NewbieXvwu/maze-car/cad/ASSETS.md

# 素材来源

本模型的几何**全部由参数生成**（dsh-cad / OCCT），没有引入任何外部模型文件。

| 项 | 来源 | 许可 |
|---|---|---|
| 整车几何 | 本项目参数化建模（`cad/params.json`） | 本项目 |
| 底板孔位 | `firmware/board/eda/board_setup.py` 的 M3_POS | 本项目 |
| 轮/电机/万向轮外形 | 按标称尺寸简化（N20、Ø42 轮、Ø12 珠万向轮 ×2 前后） | 自建 |
| 电池盒 | 按采购的 2×18650 串联盒 77×40×20 简化 | 自建 |
| 渲染/总装图 | `cad/render.py`、`cad/drawing.py` 读 `out/parts/` 逐件 STL | 本项目 |

## 若以后引入 CC0 素材

只用于**外观细节**（如轮胎花纹、螺丝头），不参与尺寸链；下载后记录：

| 文件 | 来源 URL | 许可 | 用在哪 |
|---|---|---|---|
| — | — | — | — |

原则：
- 尺寸链上的零件必须参数化，不拿扫描/下载模型顶替。
- CC0 素材只做视觉，不改 `params.json` 的数值。
- 记录来源与许可，方便后面换掉。
