NewbieXvwu/maze-car/cad/CHECKLIST.md

# 实测数据回来后的核对清单

> 用法：把实测值填进 `cad/params.json` 的 `measured` 字段（单位 mm），然后
> `python3 cad/check.py`，全 PASS 再让我重建模型。

## A. 填数前

- [ ] 卡尺/钢尺量完 `cad/MEASURE.md` 的六项关键尺寸
- [ ] 拍好照片（电机+支架侧面/底面、电池盒、主板背面、三个模块、万向轮）
- [ ] 确认轮子实际直径（标称 42，实测可能是 41–43）
- [ ] 确认电机是 N20 还是 N30（外形差 2–3 mm）

## B. 填数

- [ ] `axle.wheel_d`、`axle.wheel_w`、`axle.track`
- [ ] `motor.body_w/body_h/body_len/encoder_len/shaft_len`
- [ ] `motor` 支架孔距（模型里没有这一项，需要新增 `bracket_hole_dx/dy`）
- [ ] `battery.box_len/box_wid/box_h/x0/y0/z0`（装在两电机顶上，宽度不能超过 y ±20）
- [ ] `caster.height/base_d/ball_d`（圆形、方形两只分别量；`x_front`/`x_rear`）
- [ ] `chassis.plate_thk`、`ground_clearance`、`standoff_h`（M3×32；用 M3×30+垫片时改 30）
- [ ] `tof.module_l/module_w/module_t/hole_dx`
- [ ] `pcb` 实测厚度与 M3 孔位
- [ ] 质量：`masses.*`（有厨房秤最好，没有就按目录估）

## C. 自检

- [ ] `python3 cad/check.py` 全 PASS（重点看重心与轮子是否蹭板）
- [ ] 轮内侧面与底板边至少留 1 mm
- [ ] 主板底面比轮顶高 6 mm 以上（当前 48 vs 42）
- [ ] 电池顶离主板底至少 1 mm（当前 46 vs 48，2 mm）
- [ ] 电池盒不碰四根铜柱（内边 y 35.6、x 36.48）
- [ ] 两只万向轮的球底与两驱动轮同时着地（四轮共面）
- [ ] 镜头离地 50–100 mm，且比轮顶高 10 mm 以上
- [ ] 重心横向 |y| < 40（左右对称装配自然满足）

## D. 重建后目视检查

- [ ] 四视图里没有零件互相穿插（看 `out/render-views.png`）
- [ ] 三颗测距的镜头都没被龙门/立柱挡住
- [ ] 电机线、编码器线不被轮子扫到
- [ ] 前后万向轮球底与两轮同时着地（同一 z=0 平面）
- [ ] 整车最高点（69）不超赛道限高（如有）

## E. 电气（装车前）

- [ ] 3V3 对 GND 不短路（万用表蜂鸣档）
- [ ] VBAT 对 GND 不短路
- [ ] 三个 1×6 座的第 1 脚都是 3V3、第 2 脚都是 GND（插错会烧模块）
- [ ] I2C 扫描能看到 0x30/0x31/0x32（三颗测距）与 0x68（MPU）
- [ ] 上电顺序：先电池、后 USB（或按固件说明）

## F. 装车后

- [ ] 手动推车，四轮都着地、车头车尾都不跷，三颗测距读数随距离线性变化
- [ ] 30 cm 通道正中，左右读数都 ≈102 mm
- [ ] 手在正前方 5 cm 挡住，前测距 ≈50 mm
- [ ] 原地转向时轮子不蹭底板、线不被拉断
- [ ] 连续跑 10 分钟，Mini560 与三颗测距不烫手
