NewbieXvwu/maze-car/docs/赛情与决策.md

# 迷宫小车：赛情与决策（更新于 11/10）

## 当前进度（11/10）
- 物料全部到手；车还没组装，还没去过试车场地。开发板烧录交给了本地的 Agent。
- 开发板确认是 VCC-GND 的 YD-ESP32-S3（N8R2），排针和 DevKitC-1 相同。
- 固件已写好（`firmware/`）：逐个模块体检的串口命令、主程序、WiFi 遥测和回放。只做了电脑上的语法检查，还没在真板子上编译过。
- 洞洞板布线已排好（`firmware/board/`，交互布线图已发布成 artifact）：约 9 × 8.7 cm，52 根线分 7 步焊。为了让线横平竖直，11/10 重新分配了 GPIO，config.h 已同步。
- 组装成了关键路径：软件已经等着硬件了。

## 赛事
- 第九届长安大学迷宫智能小车大赛，电控科协承办。我们：两名大一，迷宫组（幻灯片里也叫"避障组"，两个名字混用，应该只是改名）。
- 宣讲会 11/7（周六）晚。
- **比赛 11/15（周日），暂定**；具体时间在比赛交流群（QQ）里通知，主办方也会发短信或 QQ。
- 地点：**机器人学院楼二楼，创客基地旁**。
- 试车：预计 11/9 起开放比赛场地，在开放时间内去。
- 当天流程（宣讲会原文要点）：每队至少到场一人，带车先签到；场内同时只放循迹、避障各两队，其余在实验室外等；**比赛期间不得用手辅助小车**；共三次机会，三次跑完后可以查看成绩，有异议当场提出。
- 往届参考（官网新闻）：2022 年每队约 15 分钟比赛时间、三次机会；2023 年按最终用时排名，并看是否自制，分初级组和高级组；2025 年"以赛道完成度为基础，结合完成时间"。
- 自制条款（今年原话）："自己**完全**设计电路、组装、焊接和设计程序的小车视为自制小车……自制小车不是必要的，自制难，但优势也大。"

## 赛道（宣讲会公布，已确认现场就是这张图）
- **180 × 180 cm，通道宽 30 cm**，横平竖直，正好是 6 × 6 的 30 cm 网格。已画成 `maze-sim/track_2026.txt`。
- **只有一条路**：36 格每格经过一次，没有岔路、没有死胡同、没有环。入口在左上角朝下进，出口紧挨着入口，也在上边。
- 路线：左列直下 → 底边向右 → 绕回来向左 → 中间蛇形上下四趟 → 顶边向左 → 出口。全长约 10.8 m，**14 个弯**，顺序是 `L L L R R R L L R R L L L R`（8 左 6 右）。中间蛇形是 4 个"隔一格连转两次"的 U 形弯。
- 每个弯都是"前方堵死、只有一侧能走"的拐角。
- 推论：左手、右手跑出来是同一条路线；"看图选手""记忆回放"在这条赛道上没有意义。比的就是**又快又不碰墙**。

## 已定方案
- 硬件：ESP32-S3 N8R2；N20 编码器电机 6V 300 转（1:50），配 42mm 轮子，两轮差速；四轮布局 = 左右驱动轮 + 车头/车尾各 1 只万向轮；TB6612；VL53L0X ×3（左/前/右）；MPU6050；2 节 18650 串联（电池盒骑在两电机顶上，整备约 409 g，重心 x≈+4）；固定 5V 降压。模块插在排母上，排母焊在洞洞板上；电池用防反插接头。接线表见 `firmware/README.md`，参数和坑见《硬件笔记》。
- 自制路线：用模块 + 自己画原理图 + 自己焊洞洞板 + 自己写全部程序。任何可能威胁完赛的"更纯正的自制"一律不做：没完赛的自制车，照样排在所有完赛车后面。
- 不上专业物理仿真。最大的不确定因素（VL53L0X 在纸板上的真实读数、地面摩擦、电机参数）只能实测，用真车数据校准现有的二维仿真。
- 主办方已确认：**WiFi 无线调试可以用，比赛时必须关掉**。比赛当天烧 `TELEMETRY 0` 的版本。
- 软件：沿墙走 + 左手法则，加"已知赛道模式"：不找侧面岔路，只在前墙处转弯；起步前方通就直行；转完第 14 个弯再走 35 cm 自动停车（不然出了出口会左转两次、从入口钻回去）。**不做记忆回放，不做洪水填充，不做圆弧转弯**（见下）。
- 拨码 1：稳妥档（巡航 0.38 m/s）/ 快档（只提巡航速度，默认 0.55 m/s）。拨码 2：比赛赛道模式 / 通用迷宫模式（万一布局变了的兜底）。
- 开发优先级：沿墙走稳 → 陀螺仪转弯转准 → 整条赛道稳妥档连续 10 次完赛 → 快档。
- 比赛打法：第一次稳妥档，先保住一个完赛成绩；第二、三次快档冲时间。

## 时间花在哪、怎么变快（仿真结果）
- 比赛赛道模式（和固件一致）：100 次随机扰动（墙缝、墙歪、电机差异、噪声）全部完赛，中位约 41 秒；很滑的地面 + 3 倍陀螺仪零漂也全部完赛，中位约 41.5 秒。
- 车摆在入口线外 12 cm 发车：比赛赛道模式 40/40 完赛；通用模式 32/40 失败（两侧看着空，起步就转弯了）。所以比赛时拨码 2 一定在 OFF。
- 巡航速度 0.5 m/s 约 35 秒，0.65 m/s 约 31 秒（仿真里都 100% 完赛，但仿真对真实地面偏乐观，以实车为准）。
- 11/10 快档扫描（各 40 次，比赛赛道模式）：正常地面 0.55 / 0.65 / 0.70 m/s 分别约 33.1 / 30.9 / 30.1 秒；很滑的地面加 3 倍零漂约 33.8 / 31.5 / 30.7 秒，全部完赛。0.65 以上几乎不再变快（时间都在弯里）。真车的上限是电机：带负载估计只有约 0.7 m/s，巡航超过实测 `vmax_mm_s` 的 85% 左右，就没有余量留给差速纠偏了。快档默认 0.55，实测 vmax 之后最多试到 0.6–0.65。
- **一圈里约 9 秒纯粹花在原地转弯上**。圆弧转弯是最大的提速点，但要在真车上调，时间不够，砍掉。除非 11/13 中午前稳妥档已经连续 10 次完赛，再考虑。
- 30 cm 通道里车（宽 11 cm）每边余量约 9.5 cm；车身对角半长约 8.1 cm，原地转弯不会扫墙。
- 11/10 参数调整：侧面开口阈值 `open_th_mm` 300 → 250（格距变成 300 后，300 正好卡在边上，随机迷宫里会把路口判晚）；刹车减速度 1500 → 1000 mm/s²（滑地上会冲过停车点、转弯时扫到前墙；改完不影响用时）。

## 仿真器（项目里 maze-sim/ 文件夹）
- brain.cpp 是小车的大脑，仿真和上车用的是同一份代码；sim.py 模拟电机、打滑、25° 光锥的激光测距、陀螺仪零漂、纸板墙的缝和歪斜。默认格距 300 mm。
- 跑比赛赛道：`python sim.py --maze track_2026.txt --race`。
- 真车数据回放：`python replay_log.py runs/xxx.csv --png out.png`。已经用"模拟车 → UDP → telemetry.py → csv → 回放"整条链路测过，回放和原始决策完全一致。
- 随机迷宫仍然保留，用来兜底：如果比赛当天布局和图不一样，通用模式照样能走（30 cm 格距的随机 6×6 迷宫，左右手各 60 次全部完赛）。之前写的"60 次全部完赛"其实是在 380 mm 格距下跑的（批量模式忽略了 `--cell`，已修）。
- 仿真已经找出并修掉的问题：
  1. 25° 光锥会扫到路口处横着的墙，开口看起来"开得晚"。路口中心改为吸附到网格位置。
  2. 读数介于"有墙"和"开口"之间的过渡区时，车会朝着并不存在的"远墙"靠过去。过渡区读数不再用于居中，路口中心改用更低的判定阈值。
  3. 跑一分钟以上后，陀螺仪零漂累积到 8° 以上，车斜着贴墙。改为沿墙行驶时用侧面读数随里程的变化来校正航向。
  4. 一次误读就可能让手"贴"到孤岛上无限绕圈。用航位推算记录"在哪一格、朝哪"，同一状态出现第二次就换手。
  5. 出了出口会从入口钻回去：数弯停车。
- 硬件安装要求：左右测距装在车轮轴正上方；前测距在车轮轴前方约 55 mm；车身以车轮轴为中心。装法不同就改 BrainParams。
- `claude/maze_sim.py`（左手/右手/回放/洪水填充的策略对比）是赛道公布之前写的，已经没有参考价值。

## 日程（11/10 按实际进度重排）
| 日期 | 安排 |
|---|---|
| 11/10 周二 | 开发板烧录跑通（`?` 有回应就行）；对照接线表在洞洞板上排好位置 |
| 11/11 周三 | 焊接，装一个测一个：先陀螺仪和三颗测距（`i` `g` `d`），再电机驱动和编码器（`e` `m`），最后电源和分压（`b`）。改好 config.h 里的正负号 |
| 11/12 周四 | 第一次落地：直线居中、原地转弯；用纸箱搭中间蛇形那段（约 150 × 90 cm）。场地开放就去试车（见下方清单） |
| 11/13 周五 | 整条赛道稳妥档连续 10 次完赛；再试快档 |
| 11/14 周六 | 参数 `save`；改 `TELEMETRY 0` 烧比赛版；电池充满；照接线表在嘉立创EDA画原理图；两人互相模拟问辩 |
| 11/15 周日 | 比赛（具体时间看群通知） |

分工：一人主攻硬件（焊接、接线、结构），一人主攻软件；但两个人都要能讲清整辆车。

## 待问主办方
计分规则是否沿用往届 / 计时从哪到哪，车出了出口能不能拿车 / 碰墙是否扣分、卡住怎么算 / 三次之间能否改程序、换电池 / 用模块加洞洞板算不算"完全设计电路" / 地面是什么材质。

## 第一次去试车场地的清单（场地时间紧，按顺序做）
1. 拍照和测量（约 5 分钟）：站高拍完整俯视照；多量几处通道宽度和墙厚，填进 cell_mm、wall_half_mm；看清地面材质、墙高、墙顶和接缝有没有锡箔胶带。车没装好也一定要去做这一步。
2. 静态标定（约 5 分钟）：车摆在格子正中，`d` 看三个测距，和理论值对照（侧面约 102 mm，前方停车点约 92 mm）；再把车摆在开口旁边，看开口处的读数。
3. 打滑测试（约 2 分钟）：猛起步、急停，比较编码器里程和实际走的距离。
4. 剩下的时间：整条赛道完整跑几次，全程录像；开着 telemetry.py 录数据，回去用 replay_log.py 复现。
