NewbieXvwu/maze-car/docs/采购进度.md

# 物料清单（11/10：已全部购入）

按 11/5 定下的清单原样买齐，没有换用省钱的替代款。价格留着，技术问辩被问到成本时用得上。

| 来源 | 商品 | 规格 | 数量 | 单价（元） |
|---|---|---|---|---|
| 淘宝·必晖数码 | 12GA-N20 霍尔编码器电机套装（含 42mm 轮子、支架） | 6V 300 转/分 | 3（备 1） | 19.8 |
| 淘宝·优信电子 | ESP32-S3 开发板 | N8R2，焊好排针 | 2 | 24.7 |
| 淘宝·优信电子 | VL53L0X 激光测距 | 原装 V2，6 针带 XSHUT | 5（用 3） | 14.85 |
| 淘宝·优信电子 | TB6612FNG 驱动模块 | 焊好排针 | 2 | 6.82 |
| 淘宝·优信电子 | MPU6050（GY-521） | 非国产，焊好排针 | 2 | 12.84 |
| 淘宝·优信电子 | 5V 降压 | mini560 PRO，固定 5V | 2 | 4.6 |
| 淘宝·优信电子 | 双面玻纤洞洞板 | 10×15cm / 7×9cm（练焊接） | 各 2 | 6.40 / 2.78 |
| 淘宝·优信电子 | 18650 电池盒 | 两节串联，密封带开关带线 | 2 | 2.64 |
| 淘宝·优信电子 | 杂项 | 排母、直/弯排针、2 位拨码开关、轻触开关、XH2.54 2P 端子线和插座、M3 铜柱和尼龙垫片、杜邦线、吸锡器、焊锡丝 | — | 合计约 40 |
| 淘宝·电子爱好者之家 | N20 迷你牛眼万向轮 | 圆形、方形各 1 | 2 | 1.6 |
| 京东自营 | 神火 AB2 18650 + 双槽充电器 | 2000mAh × 2（实标） | 1 套 | 44.9 |
| 京东自营 | 神火 AB2 18650 | 2000mAh × 2（实标） | 1 组 | 26.91 |
| 京东自营 | 绿林 60W 数显调温电烙铁 | 12 件套 | 1 | 41.19 |
| 京东自营 | 优利德 UT33B+ 万用表 | — | 1 | 53.3 |

合计约 466 元，其中工具（烙铁、万用表、吸锡器等）约 95 元，车本身约 370 元。

备件原则：坏一个整车就停摆、补货要等两三天、单价不高，就备一份。
