NewbieXvwu/maze-car/out/maze-car.step

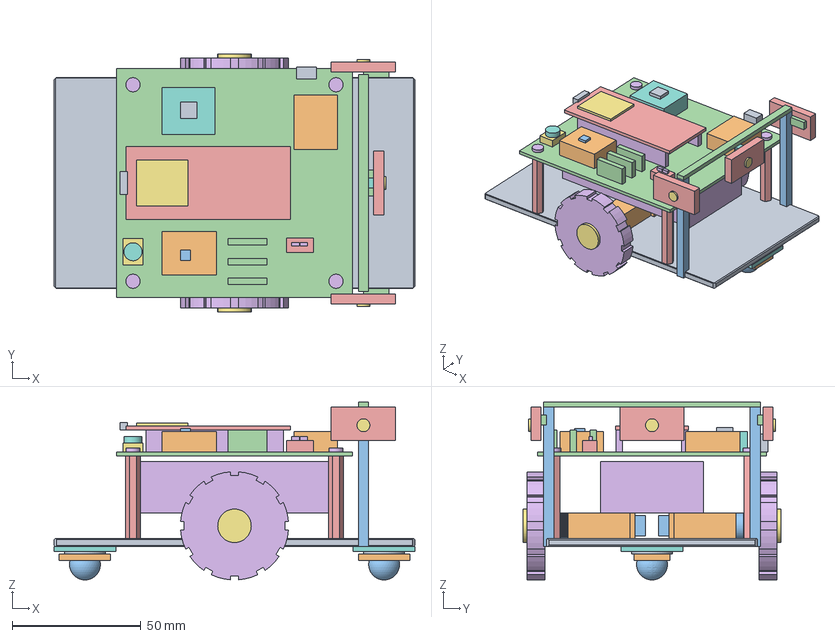
[picture p1: CAD file, 2026-11-12]
out/maze-car.step
140.0 x 100.0 x 69.0 mm
åºæ¿
å·¦çµæº-åéç®±
å·¦çµæº-ç¼ç å¨
å³çµæº-åéç®±
å³çµæº-ç¼ç å¨
å·¦çµæº-è½´
å³çµæº-è½´
å·¦è½®-è½®è
å·¦è½®-è½®æ¯
å³è½®-è½®è
å³è½®-è½®æ¯
ä¸åè½®-åºåº§
ä¸åè½®-è½¬ç
ä¸åè½®-åæ¶
ä¸åè½®-ç
ä¸»æ¿
ESP32-æ¿
ESP32-ææ¯å·¦
ESP32-ææ¯å³
ESP32-å±è½ç½©
TB6612-æ¨¡å
TB6612-è¯ç
MPU6050-æ¨¡å
MPU6050-è¯ç
æµè·åº§-å·¦
æµè·åº§-å
æµè·åº§-å³
æ¨ç å¼å ³
æ¨ç -1
æ¨ç -2
å¯å¨æé®-åº§
å¯å¨æé®-å¸½
çµæ± åº§-XH
Mini560
æµè·é¾é¨-å·¦æ±
æµè·é¾é¨-å³æ±
æµè·é¾é¨-æ¨ªæ¢
æµè·-å·¦
æµè·-å³
æµè·-å
M3èºä¸-å·¦å
M3èºä¸-å³å
M3èºä¸-å·¦å
M3èºä¸-å³å
æµè·-å·¦éå¤´
æµè·-å³éå¤´
æµè·-åéå¤´
æµè·-åæ¯æ¶
ESP32-USB
å·¦çµæº-å®è£ æ³å °
å³çµæº-å®è£ æ³å °
å·¦çµæº-è¾åºåº§
å³çµæº-è¾åºåº§
æµè·-å·¦6Påº§
æµè·-å³6Påº§
æµè·-å6Påº§
M3ç«æ±-å³å-32
M3ç«æ±-å·¦å-32
M3ç«æ±-å·¦å-32
M3ç«æ±-å³å-32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
