NewbieXvwu/maze-car/out/parts/b37-万向轮-珠.stl

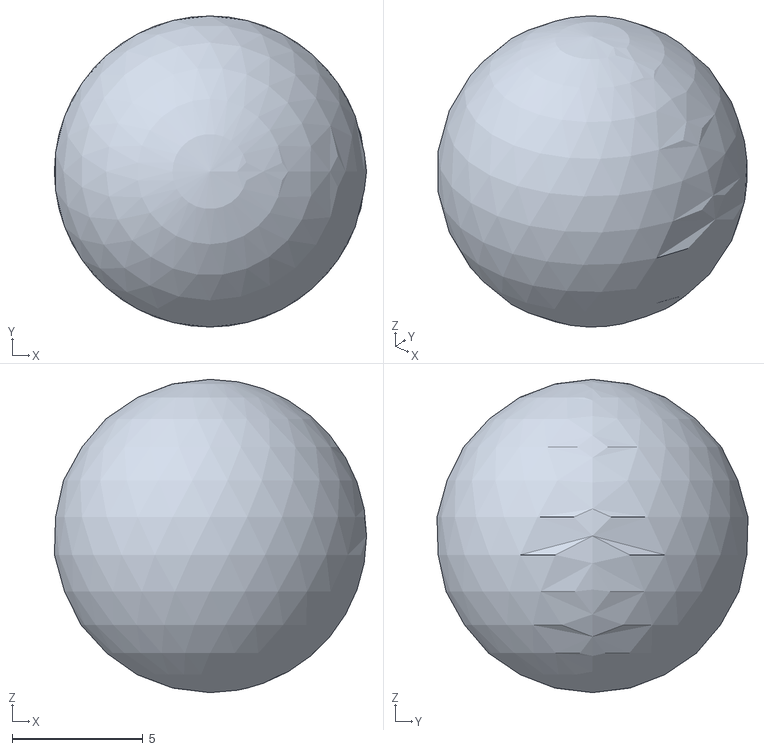
[picture p2: CAD file, 2026-11-12]
out/parts/b37-万向轮-珠.stl
12.0 x 11.9 x 12.0
