NewbieXvwu/maze-car/out/parts/b46-MPU6050-模块.stl

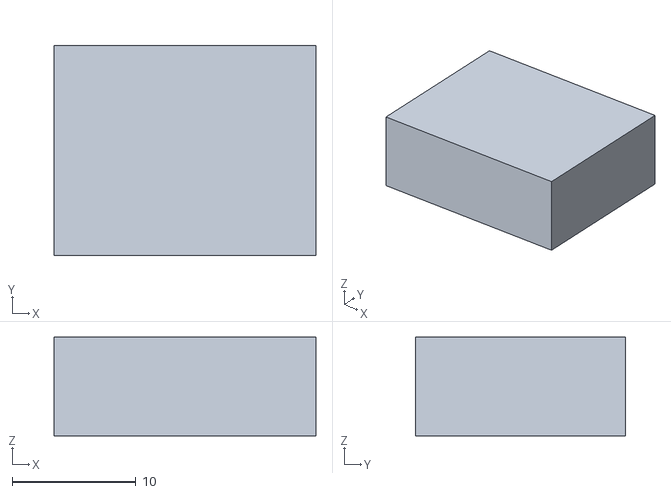
[picture p3: CAD file, 2026-11-12]
out/parts/b46-MPU6050-模块.stl
21.2 x 17.0 x 8.00
