NewbieXvwu/maze-car/out/plate.stl

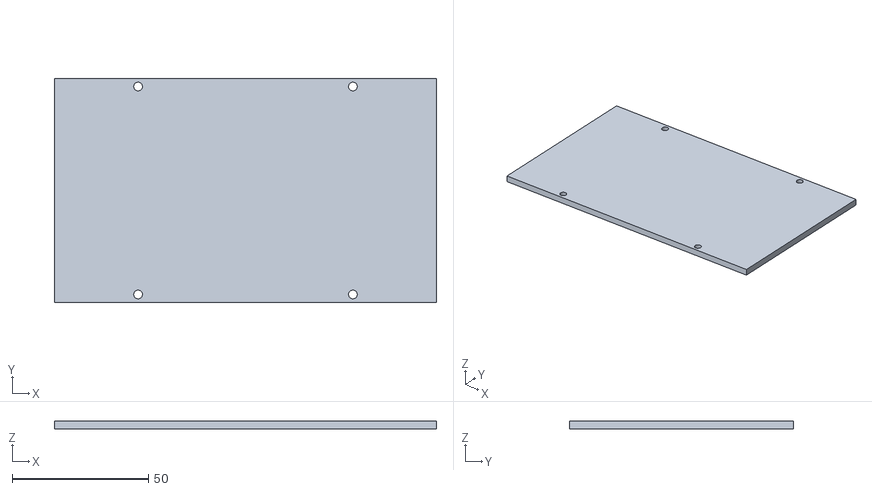
[picture p4: CAD file, 2026-11-12]
out/plate.stl
140.0 x 82.0 x 3.00
