NewbieXvwu/maze-car/out/parts/b61-测距-左.stl

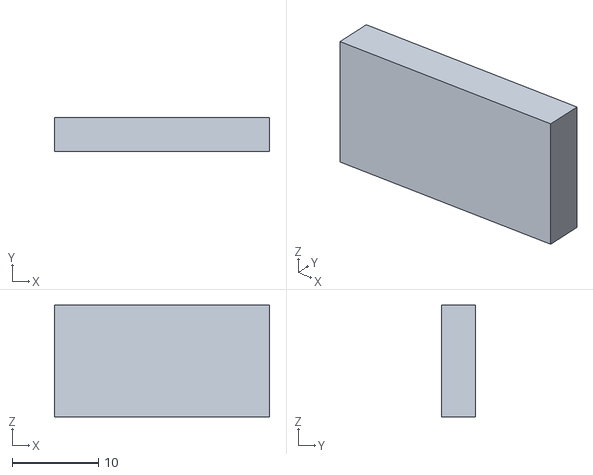
[picture p5: CAD file, 2026-11-12]
out/parts/b61-测距-左.stl
25.0 x 4.00 x 13.0
