NewbieXvwu/maze-car/out/plate-1to1.dxf

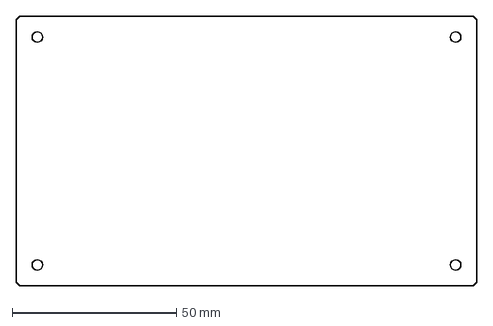
[picture p6: CAD file, 2026-11-12]
out/plate-1to1.dxf
140.0 x 82.0 mm
