NewbieXvwu/maze-car/out/parts/b136-测距-左6P座.stl

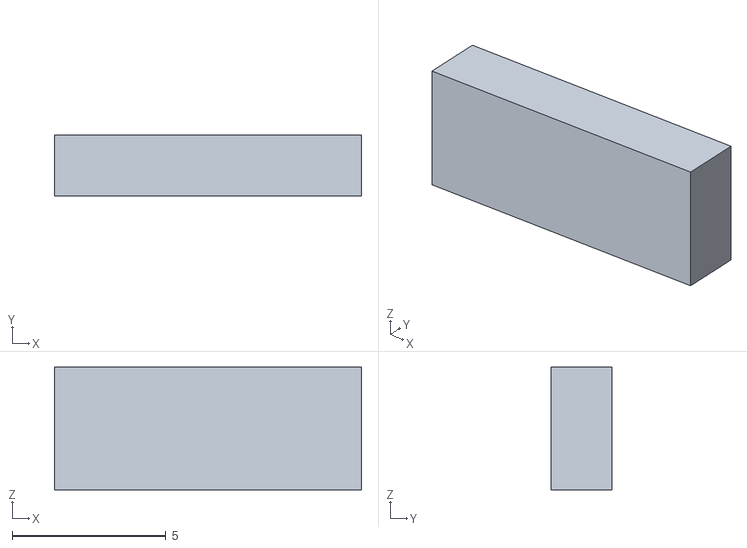
[picture p7: CAD file, 2026-11-12]
out/parts/b136-测距-左6P座.stl
10.0 x 2.00 x 4.00
