NewbieXvwu/maze-car/out/parts/b69-测距-右镜头.stl

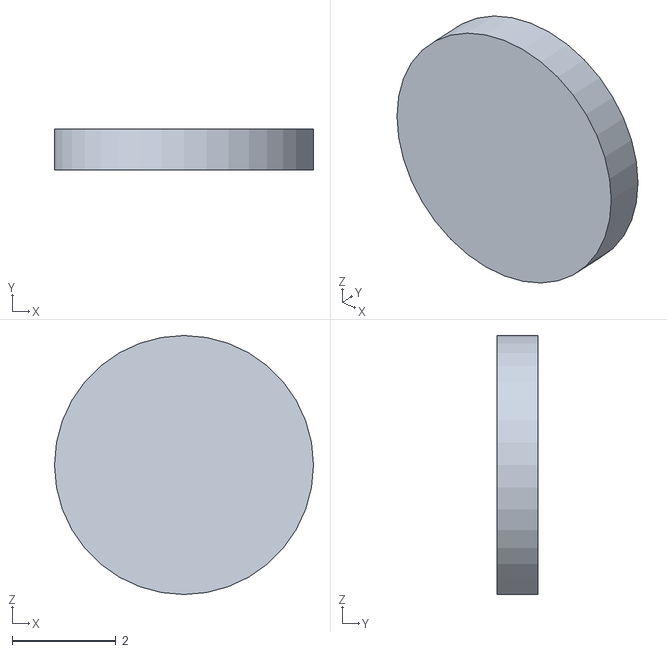
[picture p8: CAD file, 2026-11-12]
out/parts/b69-测距-右镜头.stl
5.00 x 0.8 x 5.00
