NewbieXvwu/maze-car/out/parts/b23-右电机-轴.stl

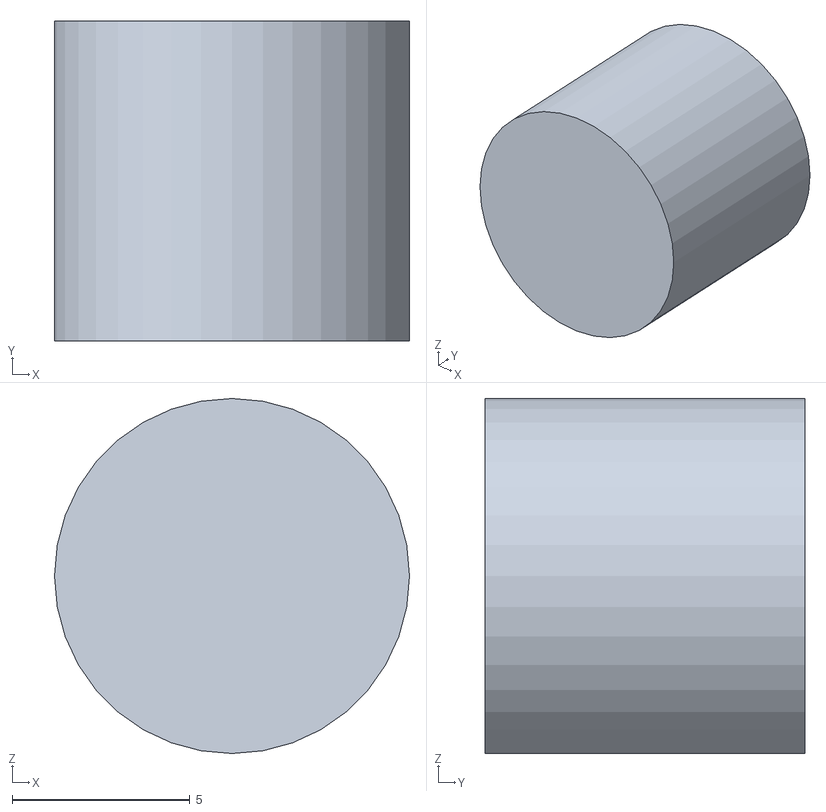
[picture p9: CAD file, 2026-11-12]
out/parts/b23-右电机-轴.stl
10.0 x 9.00 x 10.0
