NewbieXvwu/maze-car/out/parts/b67-M3螺丝-右后.stl

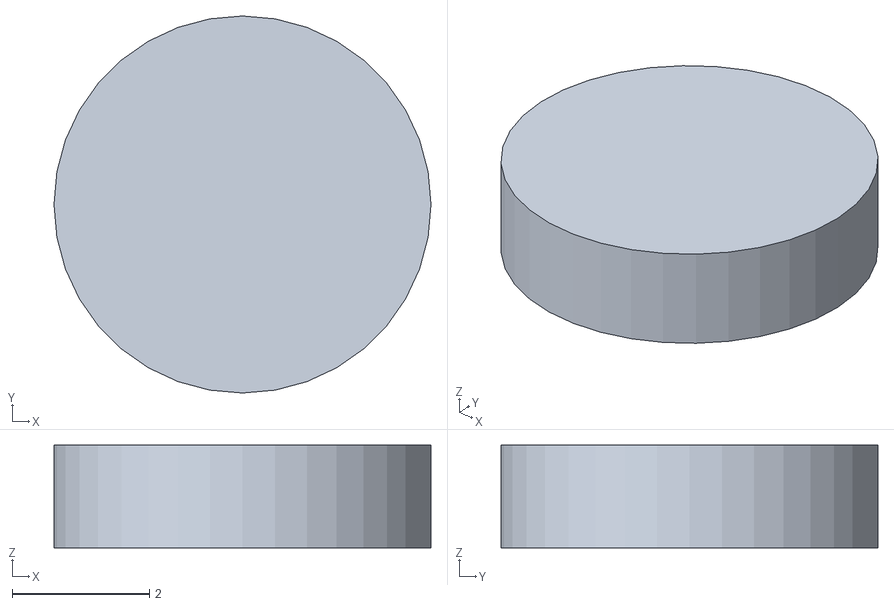
[picture p10: CAD file, 2026-11-12]
out/parts/b67-M3螺丝-右后.stl
5.50 x 5.50 x 1.50
