NewbieXvwu/maze-car/out/parts/b25-左轮-轮毂.stl

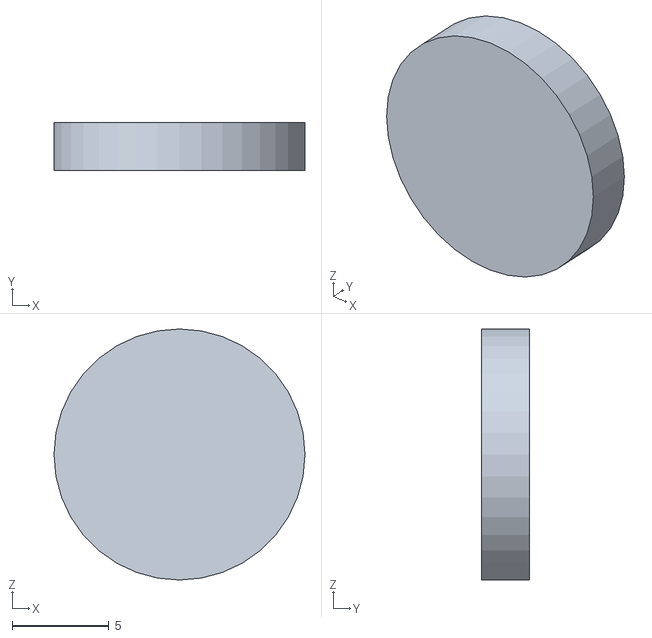
[picture p11: CAD file, 2026-11-12]
out/parts/b25-左轮-轮毂.stl
13.0 x 2.50 x 13.0
