NewbieXvwu/maze-car/out/parts/b22-左电机-轴.stl

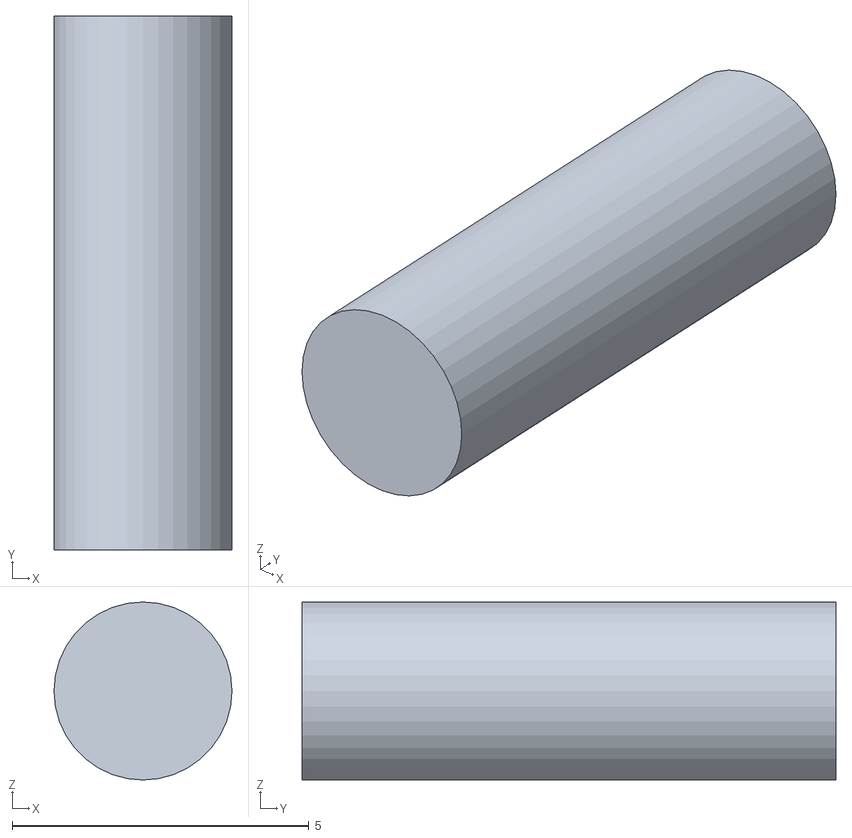
[picture p12: CAD file, 2026-11-12]
out/parts/b22-左电机-轴.stl
3.00 x 9.00 x 3.00
