NewbieXvwu/maze-car/out/parts/b169-电池包-18650.stl

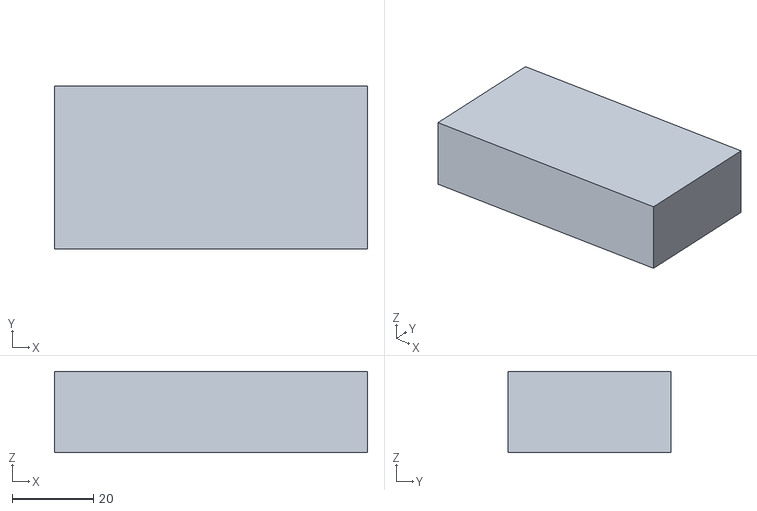
[picture p13: CAD file, 2026-11-12]
out/parts/b169-电池包-18650.stl
77.0 x 40.0 x 20.0
