NewbieXvwu/maze-car/out/parts/b171-后万向轮-转盘.stl

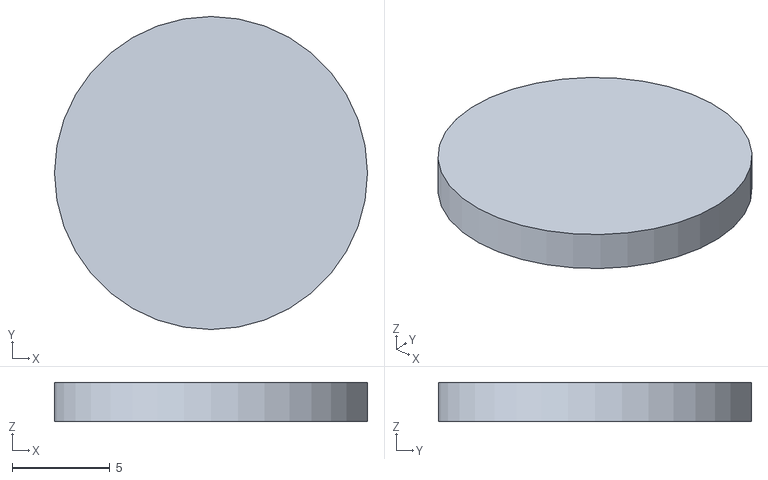
[picture p14: CAD file, 2026-11-12]
out/parts/b171-后万向轮-转盘.stl
16.0 x 16.0 x 2.00
