NewbieXvwu/maze-car/out/parts/b18-右电机-编码器.stl

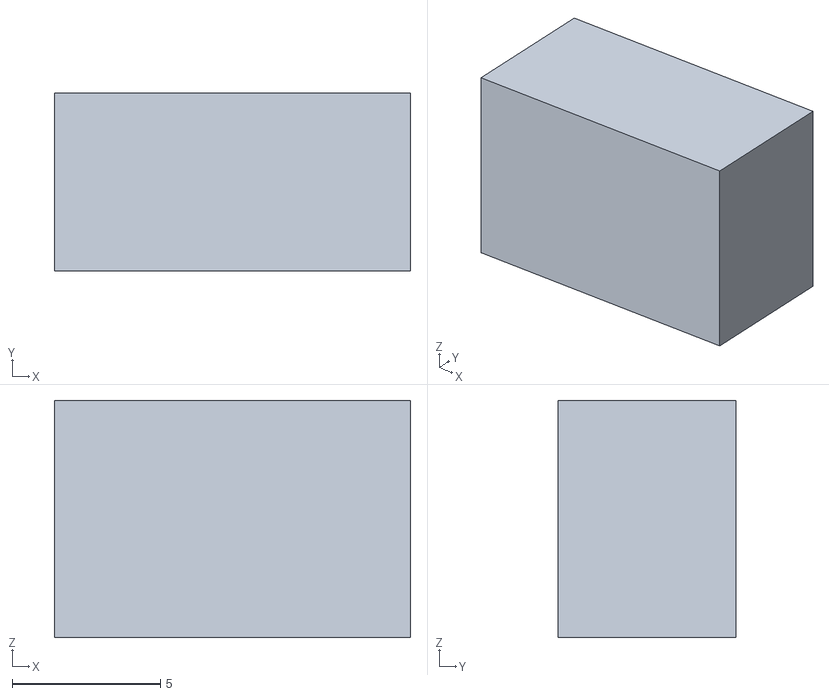
[picture p15: CAD file, 2026-11-12]
out/parts/b18-右电机-编码器.stl
12.0 x 6.00 x 8.00
