NewbieXvwu/maze-car/out/parts/b50-测距座-右.stl

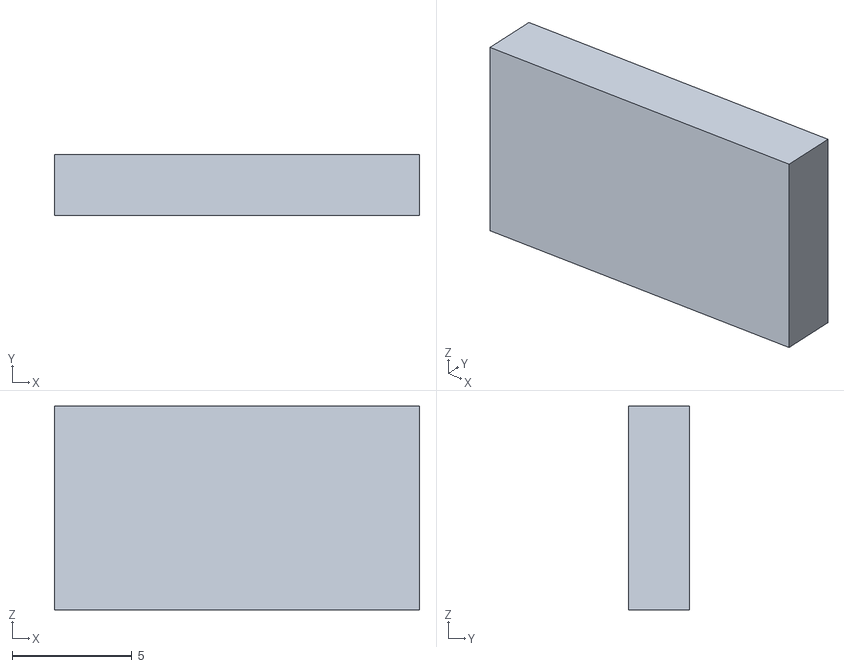
[picture p16: CAD file, 2026-11-12]
out/parts/b50-测距座-右.stl
15.2 x 2.54 x 8.50
