NewbieXvwu/maze-car/out/parts/b60-测距龙门-横梁.stl

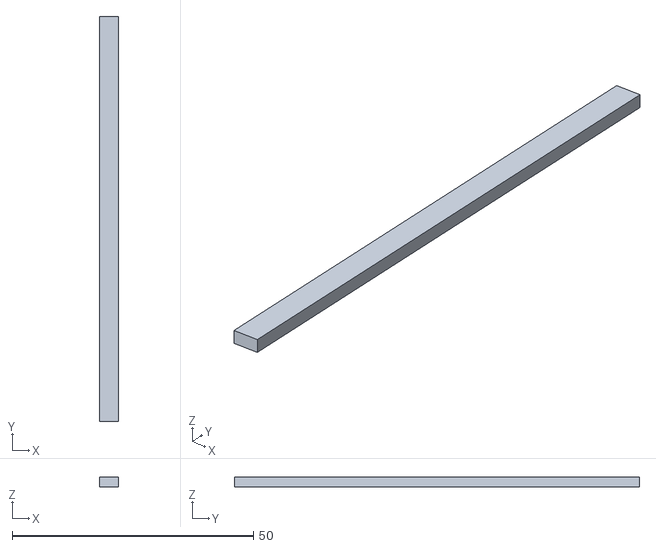
[picture p17: CAD file, 2026-11-12]
out/parts/b60-测距龙门-横梁.stl
4.00 x 84.0 x 2.00
