NewbieXvwu/maze-car/out/parts/b36-万向轮-叉架.stl

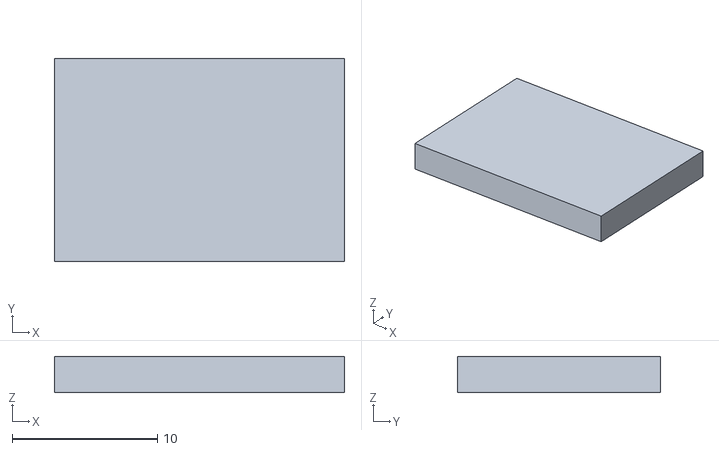
[picture p18: CAD file, 2026-11-12]
out/parts/b36-万向轮-叉架.stl
20.0 x 14.0 x 2.50
