NewbieXvwu/maze-car/out/parts/b59-测距龙门-右柱.stl

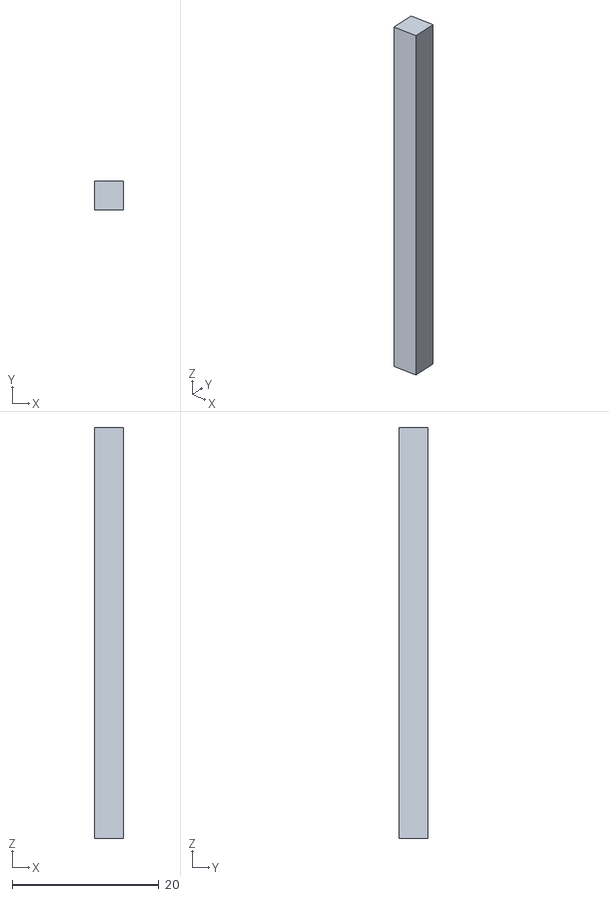
[picture p19: CAD file, 2026-11-12]
out/parts/b59-测距龙门-右柱.stl
4.00 x 4.00 x 56.0
