NewbieXvwu/maze-car/out/parts/b129-ESP32-USB.stl

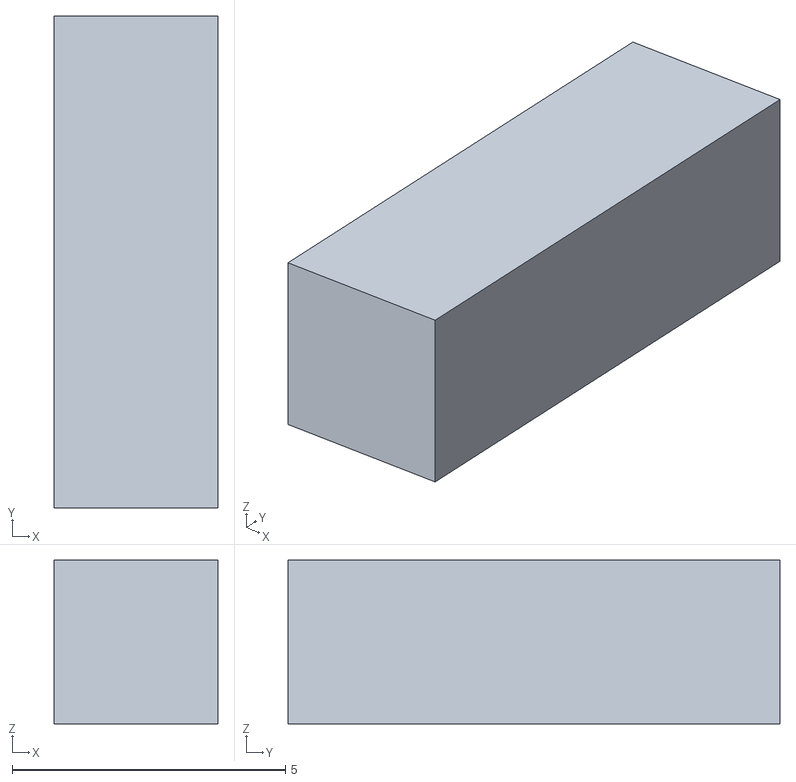
[picture p20: CAD file, 2026-11-12]
out/parts/b129-ESP32-USB.stl
3.00 x 9.00 x 3.00
