NewbieXvwu/maze-car/out/parts/b17-右电机-减速箱.stl

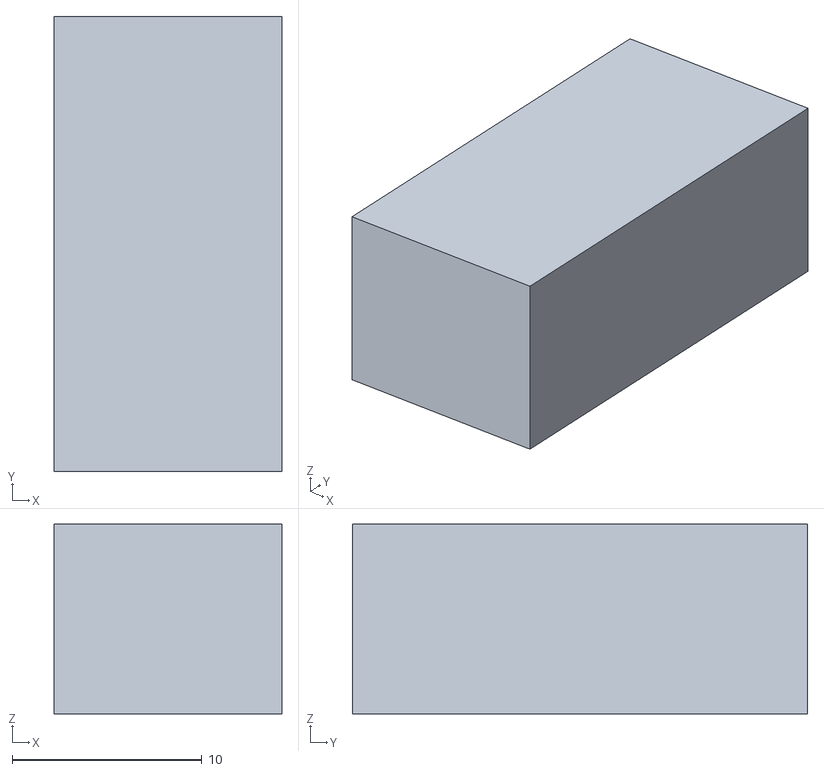
[picture p21: CAD file, 2026-11-12]
out/parts/b17-右电机-减速箱.stl
12.0 x 24.0 x 10.0
