NewbieXvwu/maze-car/out/parts/b135-右电机-输出座.stl

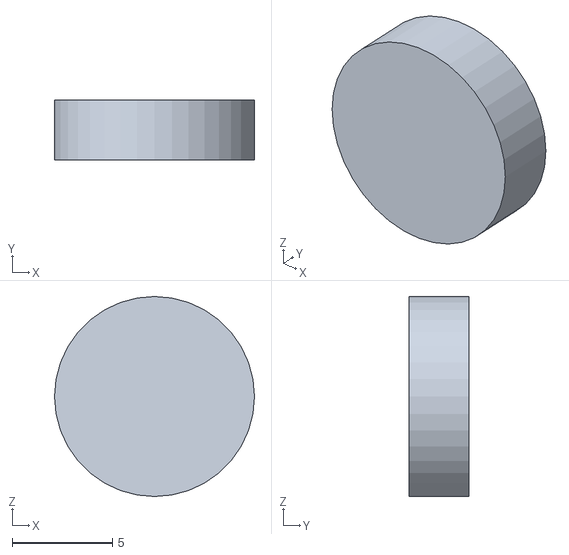
[picture p22: CAD file, 2026-11-12]
out/parts/b135-右电机-输出座.stl
10.0 x 3.00 x 10.0
