NewbieXvwu/maze-car/out/parts/b47-MPU6050-芯片.stl

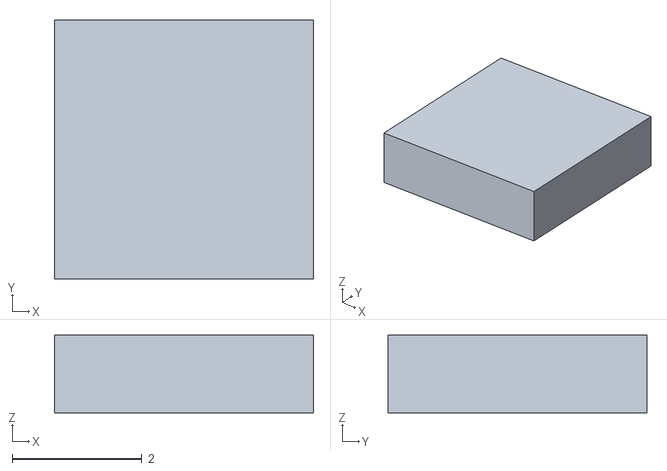
[picture p23: CAD file, 2026-11-12]
out/parts/b47-MPU6050-芯片.stl
4.00 x 4.00 x 1.20
