NewbieXvwu/maze-car/out/parts/b167-M3立柱-左后-32.stl

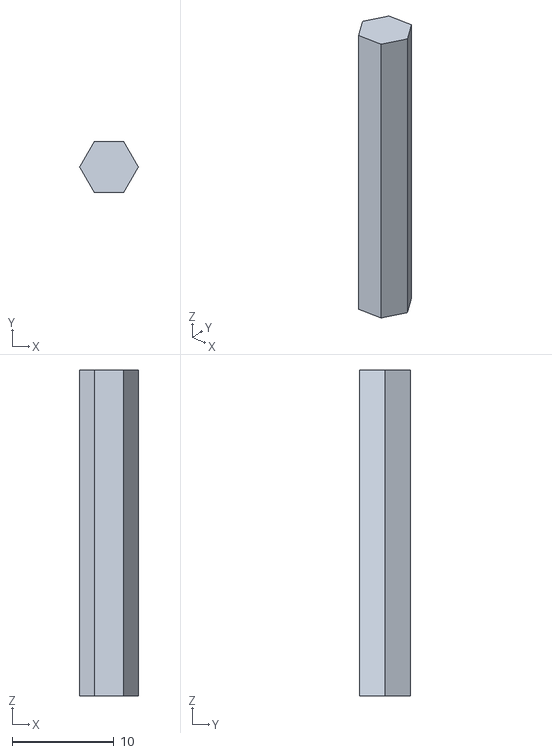
[picture p24: CAD file, 2026-11-12]
out/parts/b167-M3立柱-左后-32.stl
5.77 x 5.00 x 32.0
