NewbieXvwu/maze-car/out/parts/b131-右电机-安装法兰.stl

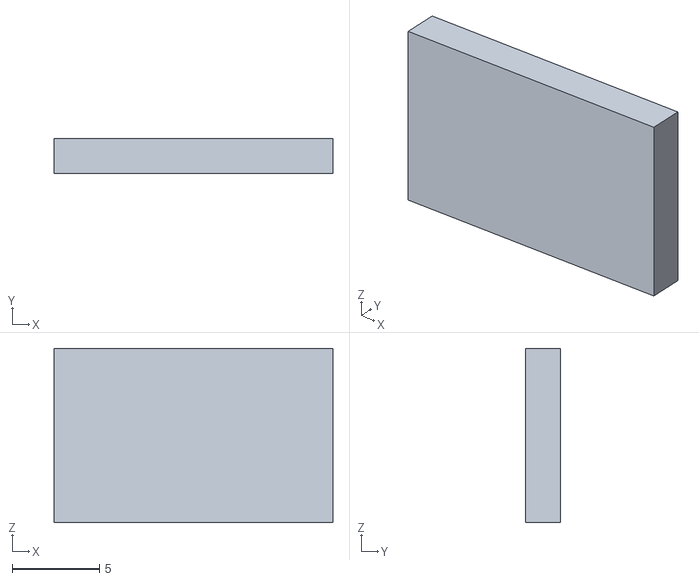
[picture p25: CAD file, 2026-11-12]
out/parts/b131-右电机-安装法兰.stl
16.0 x 2.00 x 10.0
