NewbieXvwu/maze-car/out/parts/b26-右轮-轮胎.stl

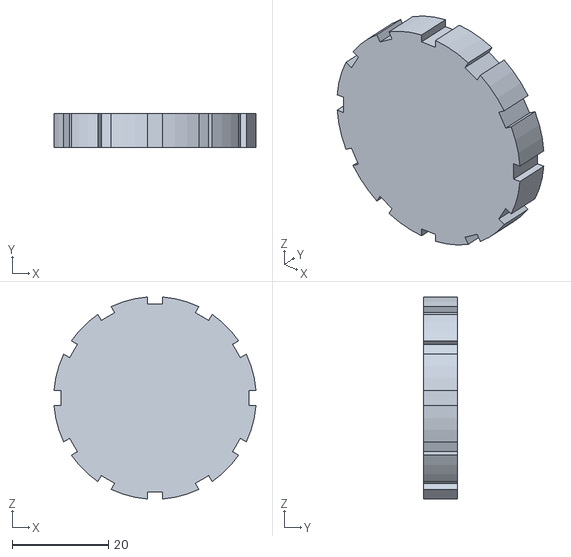
[picture p26: CAD file, 2026-11-12]
out/parts/b26-右轮-轮胎.stl
41.9 x 7.00 x 41.9
