NewbieXvwu/maze-car/out/parts/b54-启动按键-座.stl

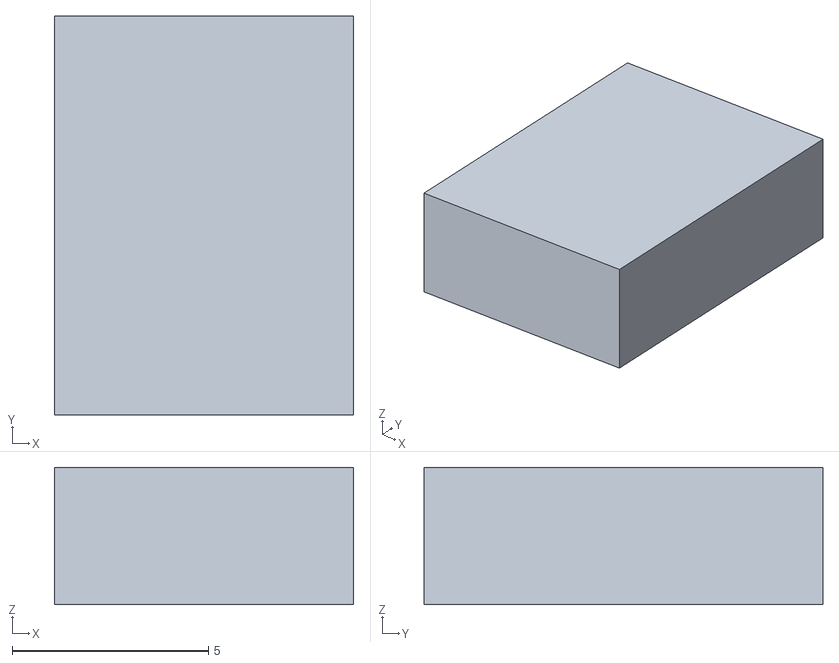
[picture p27: CAD file, 2026-11-12]
out/parts/b54-启动按键-座.stl
7.62 x 10.2 x 3.50
