NewbieXvwu/maze-car/out/parts/b40-ESP32-板.stl

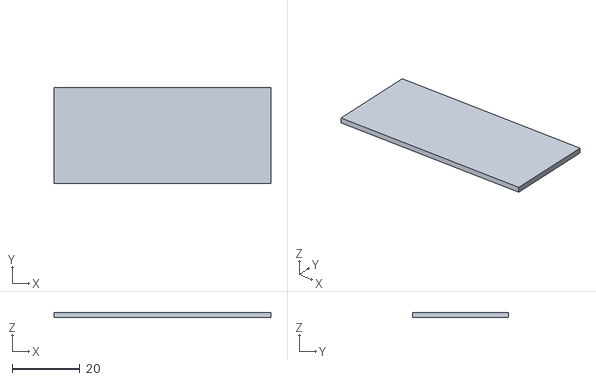
[picture p28: CAD file, 2026-11-12]
out/parts/b40-ESP32-板.stl
63.9 x 28.2 x 1.60
