NewbieXvwu/maze-car/out/parts/b52-拨码-1.stl

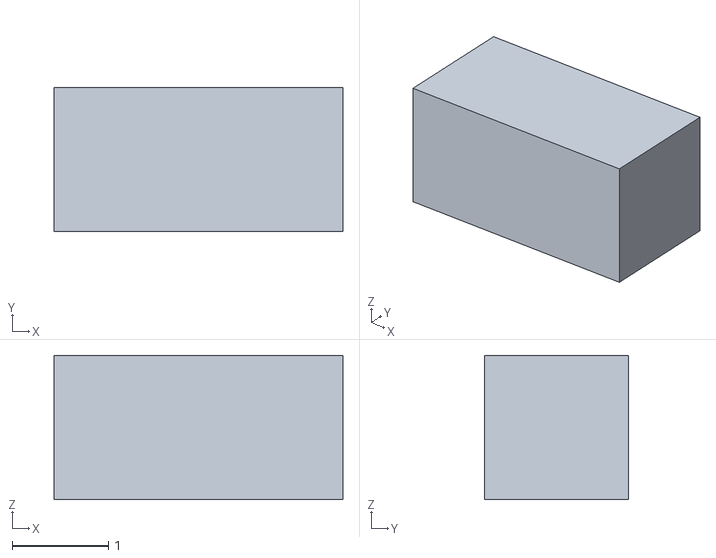
[picture p29: CAD file, 2026-11-12]
out/parts/b52-拨码-1.stl
3.00 x 1.50 x 1.50
