NewbieXvwu/maze-car/out/parts/b42-ESP32-排母右.stl

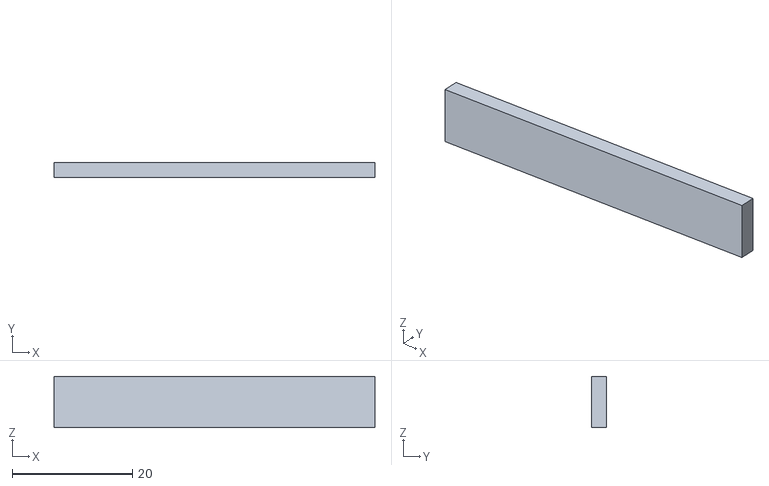
[picture p30: CAD file, 2026-11-12]
out/parts/b42-ESP32-排母右.stl
53.3 x 2.54 x 8.50
