NewbieXvwu/maze-car/out/parts/b51-拨码开关.stl

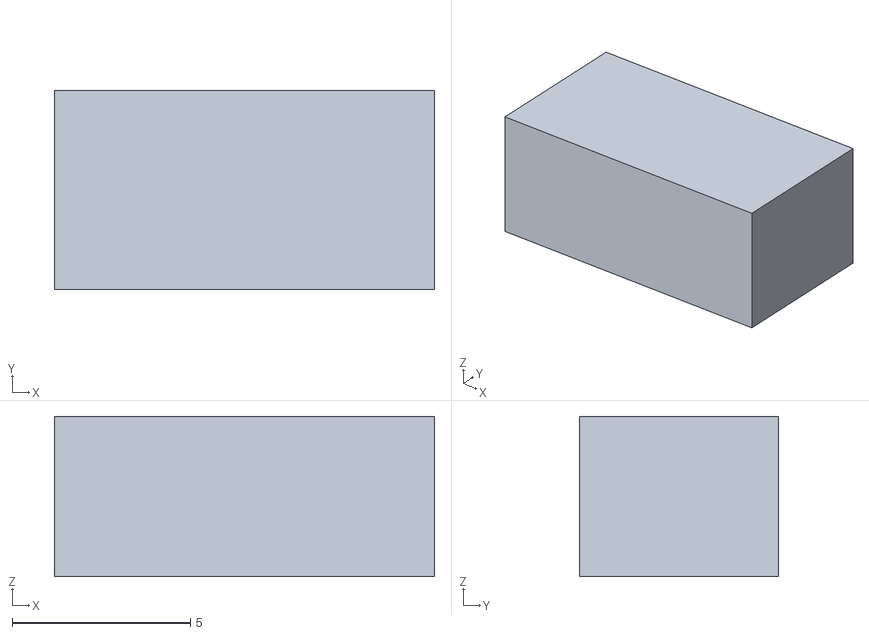
[picture p31: CAD file, 2026-11-12]
out/parts/b51-拨码开关.stl
10.7 x 5.59 x 4.50
