NewbieXvwu/maze-car/out/parts/b43-ESP32-屏蔽罩.stl

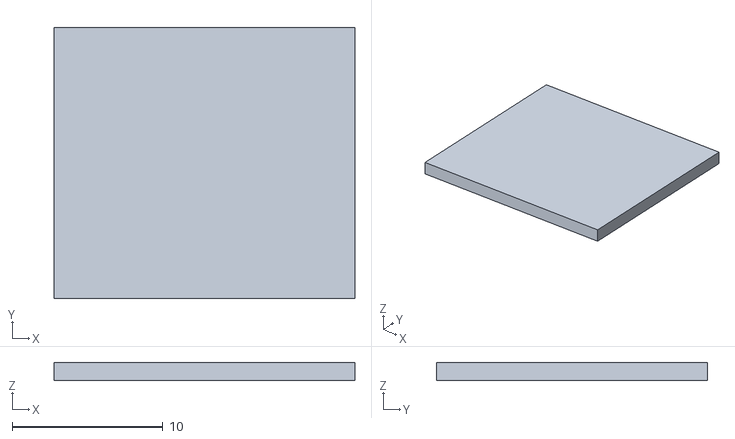
[picture p32: CAD file, 2026-11-12]
out/parts/b43-ESP32-屏蔽罩.stl
20.0 x 18.0 x 1.20
