NewbieXvwu/maze-car/out/parts/b170-后万向轮-底座.stl

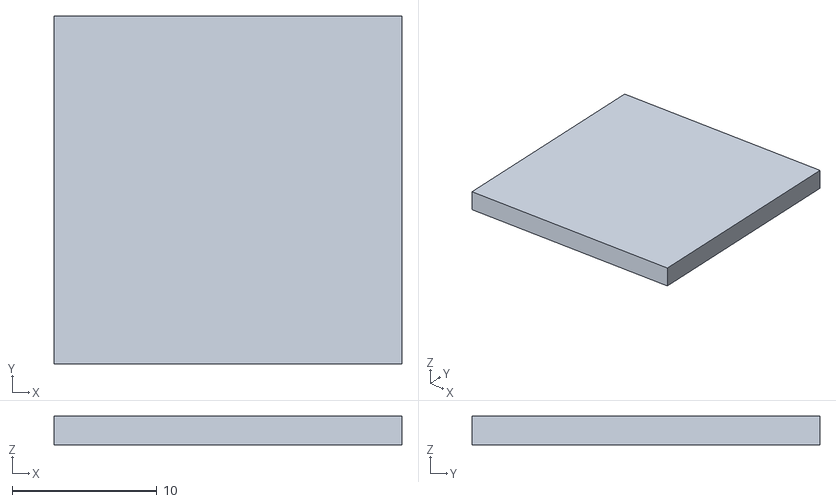
[picture p33: CAD file, 2026-11-12]
out/parts/b170-后万向轮-底座.stl
24.0 x 24.0 x 2.00
