NewbieXvwu/maze-car/out/parts/b45-TB6612-芯片.stl

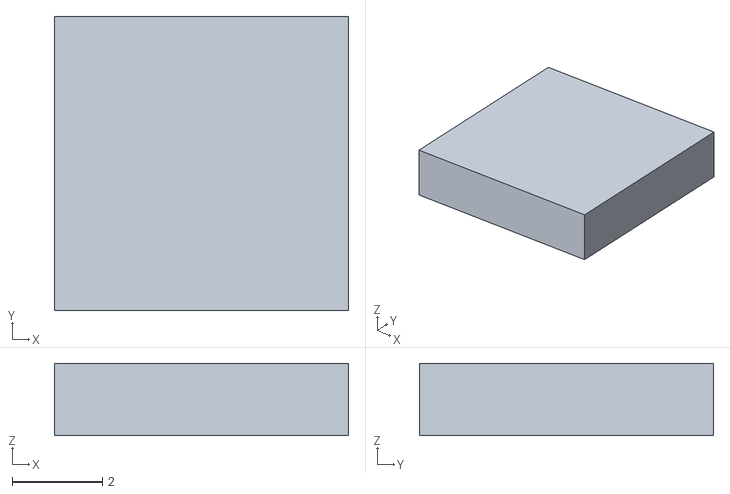
[picture p34: CAD file, 2026-11-12]
out/parts/b45-TB6612-芯片.stl
6.50 x 6.50 x 1.60
