NewbieXvwu/maze-car/out/parts/b39-主板.stl

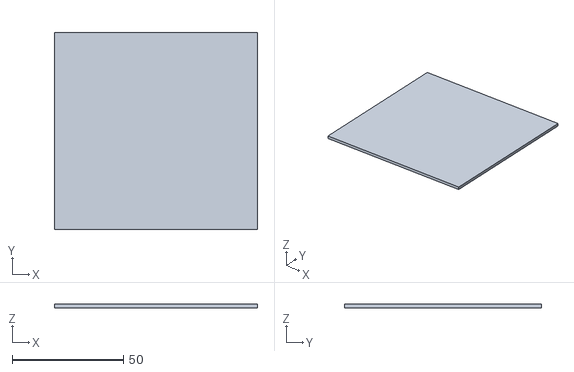
[picture p35: CAD file, 2026-11-12]
out/parts/b39-主板.stl
91.4 x 88.9 x 1.60
