NewbieXvwu/maze-car/out/parts/b55-启动按键-帽.stl

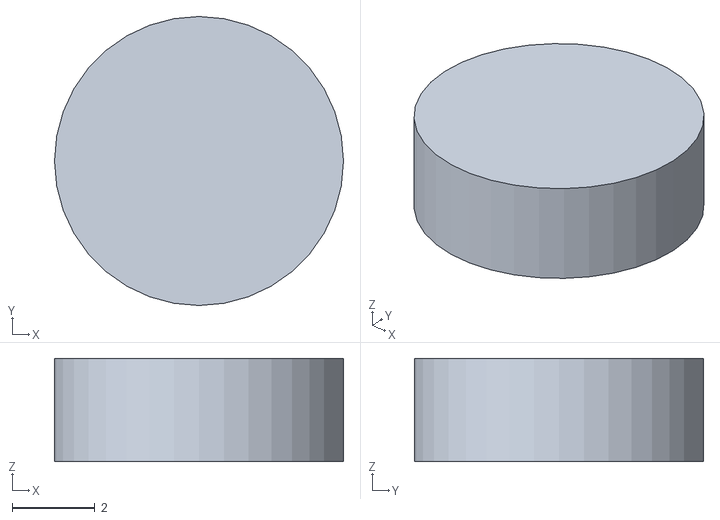
[picture p36: CAD file, 2026-11-12]
out/parts/b55-启动按键-帽.stl
7.00 x 7.00 x 2.50
