NewbieXvwu/maze-car/out/parts/b71-测距-前支架.stl

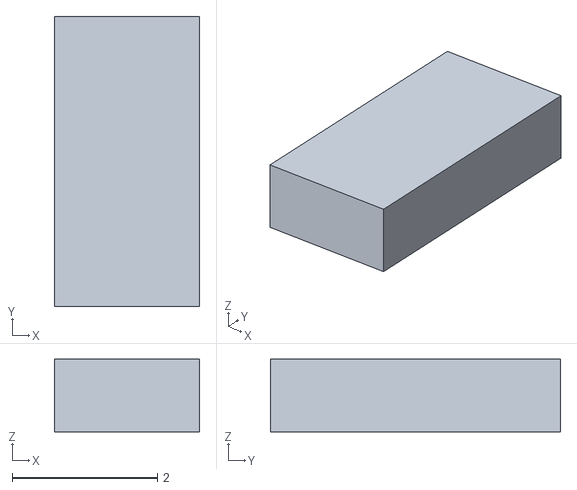
[picture p37: CAD file, 2026-11-12]
out/parts/b71-测距-前支架.stl
2.00 x 4.00 x 1.00
