NewbieXvwu/maze-car/out/parts/b56-电池座-XH.stl

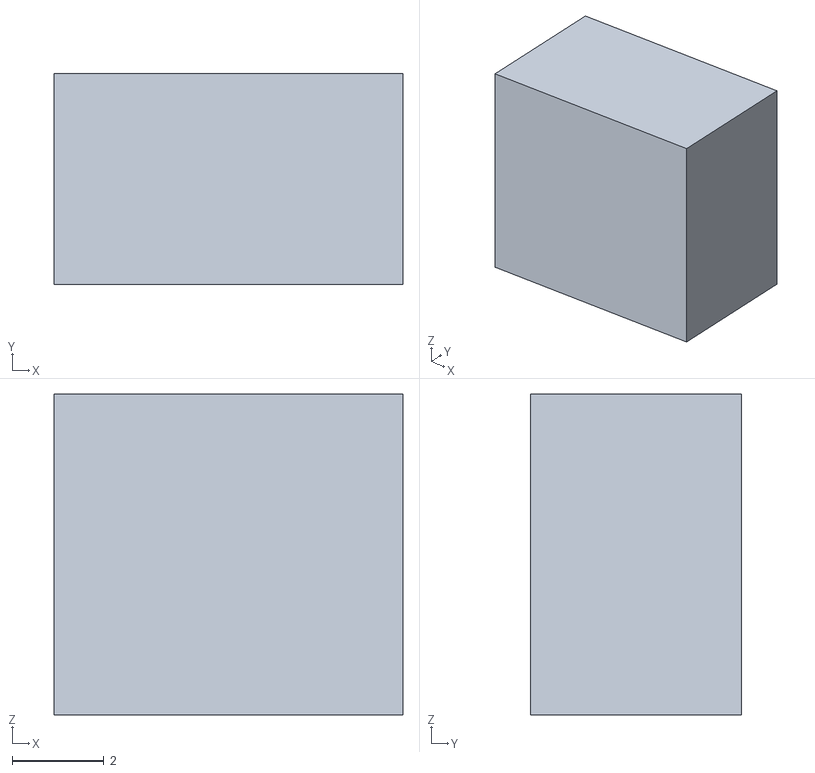
[picture p38: CAD file, 2026-11-12]
out/parts/b56-电池座-XH.stl
7.62 x 4.60 x 7.00
