NewbieXvwu/maze-car/out/parts/b44-TB6612-模块.stl

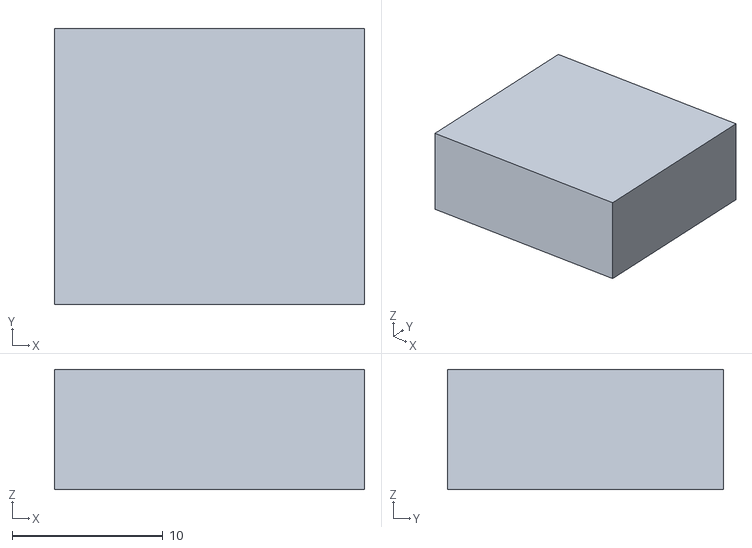
[picture p39: CAD file, 2026-11-12]
out/parts/b44-TB6612-模块.stl
20.6 x 18.3 x 8.00
