NewbieXvwu/maze-car/(list of files, cad)

Other CAD files:
out/parts/b1-底板.stl
out/parts/b64-M3螺丝-左前.stl
out/parts/b63-测距-前.stl
out/parts/b173-后万向轮-珠.stl
out/parts/b172-后万向轮-叉架.stl
out/parts/b49-测距座-前.stl
out/parts/b66-M3螺丝-左后.stl
out/parts/b35-万向轮-转盘.stl
out/parts/b68-测距-左镜头.stl
out/parts/b62-测距-右.stl
out/parts/b130-左电机-安装法兰.stl
out/parts/b15-左电机-编码器.stl
out/parts/b27-右轮-轮毂.stl
out/parts/b53-拨码-2.stl
out/parts/b166-M3立柱-左前-32.stl
out/parts/b139-测距-前6P座.stl
out/parts/b41-ESP32-排母左.stl
out/parts/b70-测距-前镜头.stl
out/parts/b48-测距座-左.stl
out/parts/b57-Mini560.stl
out/parts/b165-M3立柱-右前-32.stl
out/parts/b24-左轮-轮胎.stl
out/parts/b34-万向轮-底座.stl
out/parts/b65-M3螺丝-右前.stl
out/parts/b137-测距-右6P座.stl
out/parts/b168-M3立柱-右后-32.stl
out/parts/b58-测距龙门-左柱.stl
out/parts/b132-左电机-输出座.stl
out/parts/b14-左电机-减速箱.stl
out/maze-car.stl
out/plate.dxf
