NewbieXvwu/maze-car/cad/ASSEMBLY.md

# 整车装配说明

> 数据源：`cad/params.json`（唯一尺寸表）。图与模型都由它生成；改了 numbers 就重跑。
> 坐标：X 向前（车头），Y 向左，Z 向上；原点 = 左右轮轴线的地面中心。

## 1. 文件在哪

| 文件 | 内容 |
|---|---|
| `out/maze-car.step` | 整车 3D（装配体，可导入 SolidWorks/Fusion/Onshape） |
| `out/maze-car.stl` | 整车网格（看形状、打印占位件；由 `out/parts/` 65 个单件合并，6186 面） |
| `out/parts/` | 逐件 STL（文件名=件名），渲染与总装图的数据源 |
| `out/plate-1to1.dxf` | 底板 1:1 切割图（外框 + 4 个 M3 孔 + 倒角） |
| `out/plate-1to1.svg` | 同上，浏览器可直接看 |
| `out/maze-car-drawing.svg` | GB 第一角总装图（A3，主/俯/左 + 轴测，1:1） |
| `out/maze-car-drawing.png` | 同上，PNG 预览 |
| `out/render-iso.png` | 白底轴测渲染（带地面投影） |
| `out/render-views.png` | 四视图渲染（TOP/FRONT/LEFT/ISO，带尺寸注） |
| `cad/params.json` | 全部尺寸（nominal / measured） |
| `cad/check.py` | 尺寸链与重心自检 |

## 2. 关键尺寸一览（占位值，实测后自动更新）

| 项 | 值 |
|---|---|
| 底板 | 140 × 82 × 3，离地 13 |
| 轮 | Ø42 × 宽 7，轮距 90（轮心 y = ±45） |
| 轴心高 | 21 |
| 电机 | N20 + 编码器，坐在底板顶面（z 16–26） |
| 主板 | 91.44 × 88.9 × 1.6，板底 z 48 |
| 电池 | 2×18650 盒 77 × 40 × 20，x −38.5–+38.5，z 26–46（骑在两电机顶面） |
| 万向轮 | 前后各 1 只，x = ±58，总高 13（球 Ø12） |
| 支撑 | 四轮：左右驱动轮 + 前后万向轮，x 向支撑 −58…+58 |
| 测距镜头 | 侧：y = ±45、x = 50；前：x = 56；离地 60.5 |
| 龙门顶 | z = 69（整车最高点） |
| 整备质量 | ≈ 409 g（占位，含 2×18650） |
| 重心 | x ≈ +4.0，在四轮支撑面内 |

## 3. 叠层（从地面往上）

```
z  0 ── 地面
   0–42   轮子（轮顶 42）
  13–16   底板（洞洞板，四角 M3 孔）
  16–26   电机（坐在底板顶面，轮在板外）
  26–46   2×18650 电池盒（骑在两电机顶面，泡棉胶 + 扎带）
  16–48   M3 铜柱 ×4（M3×32，六角对边 5）
  48–49.6 主板（底面 48，高过电池顶 2、高过轮顶 6）
  49.6–61 主板上的模块（排针 8.5 + 模块 8；ESP32 USB 最高 61.1）
  54–67   三颗测距（挂在前龙门横梁下）
  67–69   龙门横梁
```

## 4. 物料清单

| # | 件 | 数量 | 规格 / 备注 |
|---|---|---|---|
| 1 | 底板 | 1 | 洞洞板 140×82×3，按 `out/plate-1to1.dxf` 切 |
| 2 | M3 铜柱 | 4 | M3×32 六角（对边 5），底板→主板；缺货用 M3×30 + 2 mm 尼龙垫片 |
| 3 | M3 螺丝 | 8 | M3×6 盘头 + 螺母/垫片，固定主板与铜柱 |
| 4 | N20 电机 | 2 | 带编码器，轴 Ø3 D 型 |
| 5 | 轮 | 2 | Ø42 橡胶轮，配 Ø13 轮毂 |
| 6 | 万向轮 | 2 | Ø12 珠，总高 13（与底板离地一致）；圆形/方形各 1，分别装车头/车尾 |
| 7 | 电池盒 | 1 | 2×18650 串联带开关，77×40×20，含电池约 105 g |
| 8 | 主板 | 1 | 91.44×88.9，四角 M3 孔 |
| 9 | 模块 | — | ESP32-S3、TB6612、MPU6050、VL53L0X×3、Mini560 |
| 10 | 排针/排母 | — | 1×6 ×3（测距座）、2.54 单排若干 |
| 11 | 龙门 | 1 套 | 4×4 木条/铝条 2 根 + 横梁 1 根 + M2 螺丝 6 |
| 12 | 6P 杜邦线 | 3 | 主板三个座 → 三颗测距，约 100 mm |
| 13 | 扎带/热熔胶 | 若干 | 电池、线束、测距座应力释放 |
| 14 | 泡棉双面胶 | 若干 | 电池盒坐在电机顶面，先贴胶再上扎带，防滑防振 |

## 5. 装配顺序

1. **切底板**：按 `out/plate-1to1.dxf` 激光/手锯切外框，钻 4 个 Ø3.2 孔；四角倒 1 mm 去毛刺。
2. **装立柱**：4 根 M3×32 铜柱拧进底板（x ±39.37，y ±38.10），力矩别大，洞洞板会裂。
3. **装电机**：N20 法兰（16×2×10）贴在底板顶面，减速箱朝内（y 8.5–32.5），编码器朝车中线；轴从法兰伸出，装轮毂 + 轮。左右镜像。轮顶 42，底板 13——轮子完全在板外。
4. **装万向轮**：车头 x=+58、车尾 x=−58，y=0，底座 24×24，各四颗 M2 自攻；两只外形不同（圆/方），分别装头尾；确认两只球底与两轮同时着地（总高 13），不等高用 M3 尼龙垫片垫。
5. **放电池**：电池盒骑在两电机顶上，x −38.5–+38.5、y ±20、z 26–46；底面贴泡棉双面胶，再用两条扎带从底板孔兜住；出线朝车头，接主板 XH 座（板上前左角）。
6. **装主板**：四个 M3 孔对准铜柱，M3×6 固定；板底 48，检查与电池顶（46）留 2 mm、与轮顶（42）留 6 mm。
7. **装模块**：ESP32、TB6612、MPU、Mini560、拨码、按键按丝印插；三个 1×6 座在板右侧（y −22.86/−30.48/−38.1），**先别插测距线**。
8. **装龙门**：两根 4×4 立柱从底板 x 48–52、y ±40 立到 69，横梁 4×84×2 在 67–69；三颗测距用 M2 挂在横梁下：侧两颗 y = ±45（镜头朝外），前一颗 x = 56（镜头朝前），镜头中心离地 60.5。
9. **接线**：三根 6P 线从主板右侧三个座引到龙门——左/右/前三根等长，沿立柱扎紧；线在模块背面留 8–10 mm 插头空间。

## 6. 底盘孔位

```
        y = +41 ┌──────────────────────────┐
   (−39.37, +38.10) ●                  ● (+39.37, +38.10)
                │      140 × 82          │
   (−39.37, −38.10) ●                  ● (+39.37, −38.10)
        y = −41 └──────────────────────────┘
                 x = −70              x = +70
```
- 孔 Ø3.2（M3 过孔），孔心距板边 6.35。
- 电机法兰 4 个 Ø2 自攻孔按实物配钻（模型里未定孔位，实测后补）。

## 7. 走线

| 线 | 从 | 到 | 走法 |
|---|---|---|---|
| 左电机 2 根 | 左减速箱 | TB6612 A 路 | 沿底板左边缘向后，扎在板下 |
| 右电机 2 根 | 右减速箱 | TB6612 B 路 | 同上，右侧 |
| 编码器 4 根 | 两电机尾部 | ESP 左列 | 车轴后方横穿，走板下 |
| 电池 2 根 | 电池盒开关/出线 | 主板 XH | 从两电机之间引到前左角，短线，避开轮子 |
| 测距 6P ×3 | 主板右列三座 | 龙门三颗 | 沿右立柱上行，同一束 |
| Mini560 输出 | 板左前 | 5V 排针 | 板面短线 |

## 8. 相对原设计的偏差（有意为之）

| 项 | 原设计 | 现在 | 原因 |
|---|---|---|---|
| 侧测距位置 | 车轴正上方 x≈0 | x=50 前龙门 | 主板 91×89 正好盖住车轴，立柱无处置根；侧向读数在直道等价，弯道略提前 |
| 万向轮 | 车尾 1 只 | 车头、车尾各 1 只 | 四轮着地更稳、过坡不点头；前后都装，重心落在支撑面中间 |
| 底板宽 | 94（整块洞洞板） | 82 | 轮距 90 时 94 宽会压到轮子 |
| 电池 | 2S LiPo 55×32×18 压底板 | 2×18650 盒 77×40×20 骑在两电机顶 | 采购就是 18650 盒；底板面层前后只剩 38 mm 放不下，抬到电机顶上正好把重心压在驱动轮轴（x≈0），主板只抬 3 mm |
| 主板 | 底板上另加顶板 | 主板即顶板 | 少一层、少 4 根柱子，重心更低 |

## 9. 模型简化说明（看图时别误会）

| 项 | 模型里 | 实物 |
|---|---|---|
| 电池固定 | 独立方块，没画泡棉胶/扎带 | 底面泡棉双面胶 + 2 条尼龙扎带兜住；电池盒只压在 12 mm 宽的电机顶面上，胶和扎带都要 |
| 线束 | 不画 | 按 §7 走线，用扎带固定在立柱和板下 |
| 螺丝 | 只画 M3 头部 Ø5.5×1.5 | 螺纹忽略；铜柱按六角 5mm 对边建 |
| 测距模块 | 25×4×13 方块 + Ø5 镜头孔 + 6P 排针示意 | GY-530 带两个 M2 孔，镜头窗偏一侧 |
| 轮胎 | 12 条径向槽示意胎纹 | 橡胶轮，槽更深 |
| 万向轮 | 前后同款（镜像），方形底座 | 圆形、方形各 1，底座孔位不同，按实物配钻 |

## 10. 还没实测的项

见 `cad/params.json` 里 `measured: null` 的项，以及 `cad/MEASURE.md` 的六项关键尺寸。填完跑 `python3 cad/check.py`。
