NewbieXvwu/maze-car/docs/PCB下单与装配.md

# 主板下单与装配

> 板子已经画完，`out/gerber/maze-car-gerber.zip` 就是可以直接上传的制造文件。
> 本文只管"怎么变成一块能用的板"。图纸背后的数据源见 `firmware/board/eda/README.md`。

## 一、这块板是什么

| 项 | 值 |
|---|---|
| 尺寸 | 91.44 × 88.90 mm（3.6 × 3.5 英寸），四角 R3.05mm 圆角 |
| 层数 | 2 层 |
| 孔 | 112 个 1.0mm（模块排针，2.54mm 栅格）+ 4 个 3.2mm（M3 安装孔，四角） |
| 走线 | 150 段，信号 12 mil、电源 20 mil；顶层 20 段（9 段跨线 + 11 段电源桥接），底层 130 段 |
| 阻焊 | 112 个排针孔正反两面都开了窗（开窗 1.83mm，焊盘 1.66mm，大 0.17mm）——**这点最容易被漏掉，漏了就是排针焊不上** |
| 丝印 | 每个模块的英文名（`ESP32-S3`/`TB6612`/`TOF L`…）+ 位号 + 1 脚标记 `1`；BT1 用 `+`/`-` 标正负极；板边标题与日期。全部是英文/数字线条字，位号与名称统一 70 mil 字号（实测墨迹高约 1.1–1.3mm，嘉立创下限 1.0mm），线宽 7–8 mil（0.18–0.20mm，下限 0.15mm） |
| 连接点 | 全部是镀通孔（via），没有贴片焊盘 —— 这是一块纯通孔的手工焊接板 |

## 二、下单（嘉立创）

1. 打开 <https://www.jlc.com> → 上传 PCB 文件 → 选 `out/gerber/maze-car-gerber.zip`
2. 系统会自己读出尺寸和层数，**核对一下是不是 91.44 × 88.90mm、2 层**
3. 参数按下表选，和券对齐：

| 参数 | 选 |
|---|---|
| 板子层数 | 2 层 |
| 尺寸 | 91.44 × 88.90 mm |
| 数量 | 5 片 |
| 板厚 | 1.6 mm |
| 铜厚 | 1 oz |
| 阻焊颜色 | 绿色（券不含彩色） |
| 字符颜色 | 白色 |
| 表面处理 | **无铅 OSP** ← 券指定的，选别的券就失效 |
| 阻焊覆盖 | 过孔开窗（我们已经在文件里画了开窗，不用勾"过孔盖油"） |
| 阻抗 | 不需要 |
| 加急 | **48 小时免费加急** |

4. 结算页手动勾选「1-6层板 OSP EDA 专用券」，价格应变成 0 元（只付运费）
5. 提交后等审单（明早开工后会走单），48 小时发货 + 快递 1–3 天

### 只有一个提示，正常

- **"网表与原理图不一致"**：这块板的 PCB 用"裸孔 + 实铜"表示连接，没有元件焊盘，
  和原理图的符号表示天然对不上。不影响制板，忽略即可。

（`Drill_PTH_Through_Via.DRL` 那份重复的钻孔文件**已经从交付包里删掉了**——嘉立创 EDA 4.1.97
会把过孔同时写进两份钻带，而板厂只承诺插件孔公差、"过孔盖油"也只管过孔。所以包里现在 11 个文件、
只有一份钻带；如果你重新导出，记得再删一次。）

## 三、收货后先别插模块（5 分钟万用表检查）

板子有 116 个孔，一旦哪个孔和相邻网络短路，模块插上去就烧。按顺序做：

1. **看外观**：四角圆角是否完整、112 个孔是否都透光、孔环是否两面都有铜。
2. **测短路**（万用表蜂鸣档，任意两个网络之间应当"不响"）：
   - `VBAT` ↔ `GND`
   - `5V` ↔ `GND`
   - `3V3` ↔ `GND`
   - `5V` ↔ `3V3`（这两个是降压前后的不同电源，必须不通）
   - **电池座自己的两个孔之间**（丝印标了 `+` 和 `-`，一个是 VBAT 一个是 GND，
     好板必须"不响"，响了就是板子短路）
3. **测导通**（应当"响"）：
   - 电池座的 `+` 孔 ↔ 任意一个 `VBAT` 孔（例如 U7 第 1 脚 `IN+`）
   - 电池座的 `-` 孔 ↔ 任意一个 GND 孔（例如 U7 第 2 脚 `IN−`）—— 全板的 GND 现在是一整片
   - 任意两个 GND 孔之间（例如 BT1 的 GND 与 ESP 第 22 孔）
   - 任意两个 3V3 孔之间（例如 ESP 第 1 孔与 U4 的 `VIN`）
4. **试插**：拿一只 2.54mm 排针/排母插几个孔，要松、要正、不要卡。

有任何一条不对，别上电，先告诉我。

### 上板前还要比一次实物（不用通电，一分钟）

板子的孔位是照布线图生成的，**没有跟实物逐块对过**。焊排母之前，把每个模块平放在板上、
让它的排针尖对着自己那一组孔，然后看两件事：

- 模块 PCB 上印的引脚名（`VIN`/`GND`/`SCL`…）跟本文件第五节的表一致；
- 模块 1 脚（方焊盘或圆点那一侧）对着板上的 `1`。

**所有模块都可能 180° 插反，而且大多真能插进去**——只要孔距一致，转半圈照样落进孔里。
反了不会插不进去，是会烧东西：

| 模块 | 反着插会怎样 |
|---|---|
| U1 ESP32-S3（2×22） | 模块的 3V3（1、2 脚）落到板上 GND（44、43 孔），模块的 GND（43、44 脚）落到板上 3V3（2、1 孔）→ **3.3V 与地短在一起**；另外板上的 5V（21 孔）会灌进模块 24 脚（TX）。 |
| U2 TB6612 | 模块 8 脚（GND）落到板上 9 孔（VBAT），模块 9 脚（VBAT）落到板上 8 孔（GND）→ TB6612 反向供电、电池经 H 桥体二极管近似短路，同时 VBAT 会经模块的地铜灌进 ESP 的 GPIO。 |
| U3 MPU6050 | 模块 1 脚（VCC）落到板上 8 孔（空脚）→ **模块没有供电，不烧，但不工作**；板上的 SCL/SDA 接到模块的 XCL/XDA，模块的 INT 接到 3V3、AD0 接到 GND。 |
| J1/J2 电机线 | 模块 2 脚（3V3）落到板上 5 孔（GND）、模块 5 脚（GND）落到板上 2 孔（3V3）→ **编码器电源短路**；同时 AO1/AO2（或 BO1/BO2）对调。 |
| U4/U5/U6 测距 | 模块 1 脚（VIN）落到板上 6 孔（XSHUT）、6 脚（XSHUT）落到板上 1 孔（3V3）→ 模块不工作，而且 XSHUT 那条 GPIO 会有电流倒灌。 |
| BT1 电池座 | 插座焊反就等于电池反接：VBAT 进 GND、GND 进 VBAT → 直接烧 U7 和 ESP；U2 的 VM 也会反向，电池经它内部体二极管近似短路，TB6612 是最先烧的那个。 |

所以只有一条规则：**板上的 `1` 必须对着模块自己标 1 脚的那一端**（方焊盘、圆点、或丝印上的 `1`）。
TB6612 再单独确认一次：`VM` 是板子**左列最上面那个孔**（第 9 孔）。

对不上就别焊，先告诉我。

## 四、焊接顺序

1. **排母/排针**（2.54mm 间距，按孔数剪）：先焊矮的、再焊高的。
   - U1：2 × 1×22
   - U2：2 × 1×8
   - U3：1 × 1×8
   - U4/U5/U6：各 1 × 1×6 **排针（公针，朝上）**——这三个模块不在板上，
     要用 6P 杜邦母头引到车头（见第七节），这里焊排母反而插不了
   - J1/J2：各 1 × 1×6
   - SW1：2 × 1×2（两排相距 7.62mm，正好卡住拨码开关的两排脚）
   - **U7 不用排母、这一步先别焊**：按布线图，Mini560 的四根线是**直接飞到四个孔上**的，
     本来要等第六节第 1 步、电池极性确认过之后再焊（先焊了就无法在接电池前保护它）。
     模块本体用双面胶或热熔胶平贴在板面（输入列在左、输出列在右，相距 27.94mm）。
   - **SW2 不用排母**：孔距是 7.62 × 5.08mm，而 6×6 轻触键的脚距约 6.5 × 4.5mm，
     要么把四只脚轻轻掰开对准孔，要么只焊对角两只脚（`A` 和 `D`，电气上够用）。
   - **BT1 不用排母**：见下面第 3 步，焊 XH2.54 卧式插座或直接焊线。
2. **别把排母焊歪**：先焊对角两个脚固定，插一只模块试一下能不能插进去，再焊剩下的。
3. **电池座**：BT1 焊 XH2.54 卧式插座（或直接焊线），`+` 在标着 `+` 的那个孔（见第五节）。
   **插电池之前先用蜂鸣档量**：`+` 孔与 `−` 孔之间**不能响**（XH 两个脚只隔 2.54mm，焊锡连上很常见，
   连上就是锂电池直接短路）。确认不响，再插电池量极性：`+` 对 `−` 应当 +7V 左右（不是 −7V）。
   XH 插头只防插反方向，防不了线序做反；这一步 10 秒，能在接 U7 之前发现电池反接。
4. 全部焊完，再做一遍第三节的短路检查（这次要带着排母测）。

## 五、插模块（方向别搞反）

每块模块的针脚顺序是**照着你自己的布线图**来的，插反了就是电源接反。

**先认 1 号孔**：板子上每个模块的丝印方框外侧都有一个 `1`，
**紧挨着这个 `1` 的那个孔就是 1 号孔**（`U7` 的 `1` 在方框正上方，对着 `IN+` 那一列；
`BT1` 不写 `1`，直接标了 `+` 和 `-`，`+` 就是 1 号孔）。
从 1 号孔开始，同列**从上往下**数：数到列底，换到另一列的最上面接着数
（`U2` 是特例：1~8 在右列、9~16 在左列，从标了 `1` 的右列开始数就对）。

只有 `U7`/`SW1`/`SW2` 是四个孔，规则不一样：
- `U7`（降压）：左列两个是 `1 IN+`、`2 IN−`，右列两个是 `3 OUT+`、`4 OUT−`。
  **不是**"左上→右上→左下→右下"——照那个接会把 5V 输出接到地。
  模块本体上印着 `IN+/IN−/OUT+/OUT−`，按本节的表接（板上只有位号和 `1`，没有 `IN+` 字样）。
- `SW1`（拨码）：上排 `1`、`2`，下排 `1'`、`2'`（`1'`、`2'` 都接地）。
- `SW2`（启动键）：左上 `A`、右上 `B`、左下 `C`、右下 `D`（`D` 接地）。

下表每行是"孔位编号:针脚名"，括号里是这个孔接的网络。

**BT1 XH**（2 孔）
  1:+(VBAT) / 2:−(GND)

**U7 M5P**（4 孔）
  1:IN+(VBAT) / 2:IN−(GND) / 3:OUT+(5V) / 4:OUT−(GND)

**U1 ESP**（44 孔）
  1:3V3 / 2:3V3 / 3:RST / 4:IO4(PWMA) / 5:IO5(AIN2) / 6:IO6(AIN1) / 7:IO7(STBY) / 8:IO15(BIN1)
  / 9:IO16(BIN2) / 10:IO17(PWMB) / 11:IO18 / 12:IO8 / 13:IO3 / 14:IO46 / 15:IO9(ENC_L_C2) /
  16:IO10(ENC_L_C1) / 17:IO11 / 18:IO12 / 19:IO13(ENC_R_C2) / 20:IO14(ENC_R_C1) / 21:5Vin(5V)
  / 22:GND / 23:GND / 24:TX / 25:RX / 26:IO1 / 27:IO2(BTN) / 28:IO42(SCL) / 29:IO41(SDA) /
  30:IO40(XSHUT_L) / 31:IO39(XSHUT_F) / 32:IO38(XSHUT_R) / 33:IO37 / 34:IO36 / 35:IO35 /
  36:IO0 / 37:IO45 / 38:IO48 / 39:IO47(DIP1) / 40:IO21(DIP2) / 41:IO20 / 42:IO19 / 43:GND /
  44:GND

**U2 TB**（16 孔，注意 1~8 在右列、9~16 在左列）
  1:PWMA / 2:AIN2 / 3:AIN1 / 4:STBY / 5:BIN1 / 6:BIN2 / 7:PWMB / 8:GND / 9:VM(VBAT) /
  10:VCC(3V3) / 11:GND / 12:AO1 / 13:AO2 / 14:BO2 / 15:BO1 / 16:GND(板上空脚，模块内部与 8/11 通)

**U3 MPU**（8 孔）
  1:VCC(3V3) / 2:GND / 3:SCL / 4:SDA / 5:XDA / 6:XCL / 7:AD0 / 8:INT

**U4 HL**（6 孔）
  1:VIN(3V3) / 2:GND / 3:SCL / 4:SDA / 5:GPIO1 / 6:XSHUT(XSHUT_L)

**U5 HF**（6 孔）
  1:VIN(3V3) / 2:GND / 3:SCL / 4:SDA / 5:GPIO1 / 6:XSHUT(XSHUT_F)

**U6 HR**（6 孔）
  1:VIN(3V3) / 2:GND / 3:SCL / 4:SDA / 5:GPIO1 / 6:XSHUT(XSHUT_R)

**J1 ML**（6 孔）
  1:M2(AO2) / 2:VCC(3V3) / 3:C2(ENC_L_C2) / 4:C1(ENC_L_C1) / 5:GND / 6:M1(AO1)

**J2 MR**（6 孔）
  1:M2(BO2) / 2:VCC(3V3) / 3:C2(ENC_R_C2) / 4:C1(ENC_R_C1) / 5:GND / 6:M1(BO1)

**SW1 DIP**（4 孔）
  1:1(DIP1) / 2:2(DIP2) / 3:1'(GND) / 4:2'(GND)

**SW2 BTN**（4 孔）
  1:A(BTN) / 2:B / 3:C / 4:D(GND)

**核对技巧**：拿万用表测某个模块的第 1 孔与它的第 2 孔，比如 ESP 的 1 孔是 3V3、2 孔也是 3V3，两个应当导通；
而 ESP 的 21 孔（5Vin/5V）与 22 孔（GND）之间必须不通。对不上就是孔位看错了，别硬插。

## 六、首次上电

0. 电池极性在第四节第 3 步已经量过了（`+` 对 `−` 约 +7V）。没量过就先别往下做。
1. **焊降压模块 U7**（mini560 之类，飞线焊在四个孔上），不插 ESP、不插电机驱动。
2. 接电池 → 测 U7 的 `OUT+` 与 `OUT−` 之间是不是 5.0V 左右。
   - 没有 5V：检查 `IN+`/`IN−` 有没有接反、电池有没有电。
   - 是 12V 或别的怪值：降压模块没调好，**别插 ESP**。
3. 确认 5V 正确后，插 ESP → 测 3V3 孔对地是否 3.3V。
4. 再插 TB6612、传感器。
5. 电机（J1/J2）**最后插**，插之前先把车架空，防止一上电就窜出去。

## 七、已知的几个"不完美"，都不影响用

- **启动键 SW2 的孔距是 7.62 × 5.08 mm**（来自布线图的 3×2 格）。如果你买的是 6×6 轻触开关
  （常见 6.5 × 4.5 mm），脚会稍微差一点：掰一下脚、或者飞两根线，或者干脆不装（用板载 BOOT 键发车）。
- **三个测距模块 U4/U5/U6 不要直接插在板上**：三列孔只隔 7.62mm，模块平躺插上去会互相顶住；
  而且传感器要装在轮轴上方/轴前（见 `docs/硬件笔记.md`）。正确做法是板上焊 1×6 **排针**（公针），
  用 6P 杜邦线引到车头的模块上，线序以板上 `1` 为准（`1` = VIN）。
- **电机接口 J1/J2 是 6 孔**：焊 1×6 排母最稳；不焊也能用——编码器的 6P 杜邦线直接插进孔里，
  但反复插拔会松，建议还是焊排母或者直接焊线。
- **丝印只有模块名和位号**，没有逐孔网络名。要认某个孔是什么网络，看第五节的表。
- **电机线是 12 mil（0.3mm）宽**，按 1oz 铜算约能过 1A、温升 10°C。N20 的空载电流 0.1~0.2A、
  堵转 0.6~1A，正常跑完全够；但不要让它长期堵转。
- **电池座 BT1 与降压模块 U7 之间只有 2mm 左右的空隙**，XH 卧式插座选窄一点的，或者插好之后看一眼会不会顶到。
- **阻焊开窗比焊盘大一圈**（1.83mm 开窗 vs 1.66mm 焊盘），有走线从旁边过的地方，
  剩下的绿油只有 **0.10mm（4 mil）宽**，正好压在嘉立创的下限上（实测最近 0.1016mm，全板 0 处低于 0.1mm）。
  不会短路，最多是那几处绿油偏窄、肉眼能看到一点铜边；如果板厂把开窗再放大一点，
  那里的一段走线会露铜——别拿镊子去刮，手工焊这几个孔时少放锡。
- **板上没有电池电压检测的分压电阻**：`config.h` 里 `PIN_BAT=1`，但 IO1 在本板上是空脚。
  IO1 悬空时 ADC 读数不可控，若落在 1~7V 会被判"电量低"拒绝发车（现象很迷惑）。
  **固件已经默认关掉这项检查**（`config.h` 新增 `BAT_CHECK_ENABLED 0`，`car.ino` 用 `#if` 包住），
  所以不焊电阻也不会误拦，出发日志里也不再报电压。想恢复真实电压检测：IO1 与 GND 之间焊 33k、
  VBAT 串 100k 到 IO1（分压比 133/33），把 `BAT_CHECK_ENABLED` 改成 1 重新编译即可。
- **没有电源指示灯、没有反接保护**：电池极性务必确认。BT1 两个孔分不清哪边是 `+` 时，
  用万用表测：与 U7 第 1 孔（`IN+`）导通的那个是 `+`，与任意 GND 孔导通的那个是 `−`。

## 八、这块板为什么长这样（给以后回看）

原始设计是一块洞洞板手焊布局（`迷宫小车主板布线.html`），35×34 格、1 格 2.54mm。
把它搬成 PCB 时保留了原来的孔位和走线，只补了三样东西：

1. GND 原本被拆成 5 块、3V3 拆成 2 块（手焊是点到点接线，不需要整片地），
   在顶层补了 5 根桥接线，让每个电源网络在板上都是一整片 —— 这样地回流才顺。
2. 加了 4 个 M3 安装孔。
3. 补了阻焊开窗（否则排针孔是盖油的）。
