NewbieXvwu/maze-car/cad/MEASURE.md

# 建模数据表

> 给 `cad/` 参数化模型用。单位 mm，不用换算。
> 量法：有卡尺用卡尺；没有就钢尺 + 拍照（零件旁放把尺子，镜头正对，别斜拍）。
> 精度：孔距 ±0.5、外形 ±1、高度 ±1 就够。估不准的先空着，我按常见值占位并在模型里标出来。

## 先量这 6 个（最影响结构）

| # | 量什么 | 怎么量 | 实测 |
|---|---|---|---|
| 1 | 电机轴心 → 支架安装面 | 电机装进支架后，轴中心到贴合车板那一面的距离 | |
| 2 | 支架安装孔距 + 孔径 | 两孔圆心距；孔径拿钻头比 | |
| 3 | 轮子宽度 | 卡尺夹轮子两侧 | |
| 4 | 轮子内侧面 → 支架安装面 | 决定轮距、底板要不要裁窄 | |
| 5 | 电池盒 长×宽×高 | 含外壳；要能放进 x ±38.5、y ±20 | |
| 6 | 万向轮总高 ×2 | 地面 → 安装面；圆形、方形分开量 | |

## 1. N20 电机 + 支架

| 项目 | 实测 |
|---|---|
| 电机本体 宽 | |
| 电机本体 高（含编码器） | |
| 电机 + 编码器 总长（不含轴） | |
| 支架外形 长 × 宽 | |
| 支架安装孔：数量 / 孔径 / 孔距 | |
| 轴径 / 轴伸出长度 | |
| 装好轮子后的总宽（轮外侧面 → 电机尾部） | |

## 2. 轮子

| 项目 | 实测 |
|---|---|
| 直径（确认 42） | |
| 宽度 | |
| 轮毂直径 | |

## 3. 万向轮（圆形、方形各 1）

| 项目 | 圆形 | 方形 |
|---|---|---|
| 总高（地面 → 安装面） | | |
| 安装面尺寸 | | |
| 安装孔位 / 孔径 | | |
| 球径 | | |
| 转动半径（球心到安装面中心的水平距离） | | |

两只总高差 >1 mm 时，用 M3 尼龙垫片垫高的那只，保证四轮共面。

## 4. 电池盒（2×18650 串联带开关）

| 项目 | 实测 |
|---|---|
| 长 × 宽 × 高（标称 77 × 40 × 20） | |
| 两节电池排布（并排 / 一前一后） | |
| 开关位置 / 出线方向 | |
| 含两节电池重量（标称 105 g） | |
| 底面是否平整（要贴泡棉胶坐在电机顶上） | |

## 5. 主板（大部分我已经查到）

| 项目 | 值 |
|---|---|
| 外形 | 91.44 × 88.90（已知） |
| 4 个 M3 孔 | 四角，孔心距板边 6.35 → 相对中心 ±39.37 / ±38.10（已知） |
| 板上最高元件（ESP32 排针 / USB 口）高度 | 待量 |

## 6. 模块

| 项目 | 实测 |
|---|---|
| TB6612 长 × 宽 × 高（含排针） | |
| MPU6050 长 × 宽 × 高 | |
| VL53L0X 长 × 宽 × 厚，两个 M2 孔距，镜头到板边 | |
| Mini560 长 × 宽 × 高 | |

## 7. 拍照清单（每张旁边放尺子）

- 电机 + 支架：侧面一张、底面一张
- 电池盒（连同出线）
- 主板背面（看 M3 孔和焊点）
- 三个模块：TB6612 / MPU6050 / VL53L0X 正面
- 万向轮侧面

## 8. 定下来的（不用量）

| 项目 | 值 |
|---|---|
| 洞洞板 | 55 × 37 孔 ≈ 139.7 × 94.0，裁到 140 × 82 |
| 测距位置 | 离中线 45、车轴前 55、镜头高 60 |
| 轮径 / 轴心高 | 42 / 21 |
| 底板离地 | 13 |
| 四轮布局 | 左右驱动轮（轮距 90）+ 车头 x=+58、车尾 x=−58 各 1 只万向轮 |
| 主板高度 | 板底 48（铜柱 M3×32） |

## 9. 已经定下来的选型（不用再选）

| 项目 | 结论 | 说明 |
|---|---|---|
| 轮距 | 90 | 底板裁到 82 宽，轮子全在板外 |
| 万向轮位置 | 车头 + 车尾各 1 | 四轮着地，过坡不点头；两只都量高、垫平 |
| 电池位置 | 骑在两电机顶上（z 26–46） | 2×18650 盒 77×40×20；底板面层前后只剩 38 mm，放不下 |
| 底板宽度 | 82 | 140 × 82 × 3 |
| 主板高度 | 板底 48 | 铜柱 M3×32；电池顶 46，留 2 mm |
