NewbieXvwu/maze-car/(list of files, drawings)

Other design files:
firmware/board/eda/pcb_plan.json
