NewbieXvwu/maze-car/(commit log)

2026-11-10 初始化：固件、仿真器、洞洞板布线、赛情笔记
    - firmware/car：Arduino 固件，大脑 brain.cpp 只保留这一份；WiFi 密码可放在不进仓库的 secrets.h
    - firmware/board：布线生成器（自检 + 交互布线图）和原理图对照表
    - maze-sim：仿真器直接编译 firmware/car/brain.cpp；真车数据回放
    - docs：赛情与决策、硬件笔记、物料清单
    - MIT 许可
    Claude-Session: https://claude.ai/code/session_019aCDrLwo7LZ9Q4AqUJrRXj
2026-11-10 接入 PlatformIO 构建：锁定 pioarduino espressif32 55.03.312-1（arduino-esp32 3.3.12），N8R2 实测 qio_qspi
    - platformio.ini：env car 编译 firmware/car，default_8MB 分区，VL53L0X 依赖；本机构建 [SUCCESS] 并已烧录验证
    - firmware/README.md：装环境章节改为 PlatformIO 命令，保留 Arduino IDE 3.x 注意事项，记录 N8R2 四线 PSRAM 实测结论
    - examples/main_minimal.cpp：PSRAM 手动初始化参考（qio_qspi 开机不自启 PSRAM）
    - .gitignore：忽略 .pio/
2026-11-10 新建嘉立创EDA正式工程 eda/（.eprj3 文件夹化格式，Git 友好）
    工程 maze-car：空白原理图 P1 + PCB1 + Panel1，实际文件存于
    仓库 eda/，嘉立创工程目录经软链接指向此处。后续原理图按
    firmware/board/netlist.md 绘制。
2026-11-10 画完原理图：12 模块 / 79 引脚 / 27 网络，逐网核对通过
    - 12 个模块符号与器件建进工程库（工程库令牌=工程UUID，非 "project"）
    - 全部 27 个网络用网络名标签连接，sch read 与 netlist.md 逐脚比对：79/79 一致、网名集合一致
    - 功能分区框 5 个（电源/主控/电机驱动/传感器/输入）、图签已填
    - sch check：0 error、0 out-of-sheet、0 floating，仅 3 条 peripheral-not-direct 告警（标签连线与工具口径不同，符合 netlist.md 约定）
    - sch drc：12 条 MISSFOOTPRINT（刻意留待 PCB 阶段按实测排针做封装）
    - 生成脚本与规格入库：gen_symbols.py / build_lib.py / place.py / specs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
    [MOTOR_L_CONN.json, MOTOR_R_CONN.json]
2026-11-10 补原理图生成脚本说明（重跑顺序与已知遗留）
2026-11-10 原理图改名为主板原理图、板子改名为主板 PCB
2026-11-10 PCB 出图可直接下单：112 孔 + 134 段走线 + 12 个模块丝印框
    针脚孔用 via 打（工程库封装写不进钻孔，实测 4.1.97 下带 hole 的
    build 会挂死并回滚）；12 个模块另建纯丝印封装，既画出占位框，
    也满足 EasyEDA "板上要有可读器件"的 Gerber 导出前置条件。
    - route_via.py：每脚一孔（1.0mm/1.66mm），44 根线 134 段（信号 12mil、电源 20mil）
    - DRC 归零：clearance/spacing/outline 0 条，剩 9 条未接针脚 + 1 条网表差异
    - 84 个带网络针脚逐个校验落在同网络铜皮上
    - out/gerber/maze-car-gerber.zip：7 层 + 钻孔（112 孔），可直接上传嘉立创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
    [MOTOR_L_CONN_PCB.json, MOTOR_R_CONN_PCB.json, pcb_plan.json]
2026-11-10 给 112 个排针孔开阻焊窗
    via 默认盖油，GTS/GBS 里 0 个开窗，模块排针插进去铜环被绿油盖住焊不上。
    pcb via 没有开窗参数，pcb_PrimitiveVia 的 solderMaskExpansion 改了也不进
    gerber（4.1.97 不认），所以改用「在阻焊层画实心多边形」：
    - mask_open.py：112 孔 × 正反两面 = 224 个 12 边形开窗（半径 36 mil）
    - 重新导出 gerber：GTS/GBS 各 112 个开窗，孔环露出 72 mil
    - README 补上开窗步骤、两个钻孔文件重复、--out 必须是新文件等坑
2026-11-10 PCB 做到可投产：补 GND/3V3 桥接、M3 安装孔、丝印清理，三道独立验证通过
    - bridge_nets.py 用 A* 在顶层补 5 根桥接线，把 GND 的 5 块、3V3 的 2 块孤岛连成整片
    （DRC 的 9 条 No Connection 全部消失）
    - 四角加 3.2mm M3 安装孔，孔数 112 -> 116
    - 清掉 11 组重复叠印的丝印，把出板的两条文字挪回板内
    - 新增 verify_board.py / verify_gerber_nets.py / audit_gerber.py 三道验证：
    板级连通性、从 Gerber 重建铜层网表（反向验证过能抓 2mm 断线）、文件级审计
    - 重新导出 out/gerber/maze-car-gerber.zip（97091B），GTS/GBS 各 112 个开窗
    - docs/PCB下单与装配.md：下单参数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
2026-11-10 交付说明补两条装配提示：电机线载流、BT1 与 U7 间距
2026-11-10 每个模块外侧标丝印 1，装配说明写清数孔规则
    - pin1_label.py: 12 个模块在丝印方框外侧标 1（框内会被模块本体挡住；
    不用圆点是因为 12 个里有 9 个会压在走线上，看着像过孔）
    - docs/PCB下单与装配.md: 补「先认 1 号孔」数孔规则，U2 的 1~8 在右列单独说明
    - Gerber 重新导出（丝印新增 12 个字符），铜层零变化：开窗 112、焊盘 116、钻孔 116
    - 三道验证重跑通过：verify_board PASS / verify_gerber_nets PASS / audit_gerber 一致
2026-11-10 说明文档订正开窗尺寸与丝印内容
2026-11-10 外部审查第一轮整改：修 U7 数孔规则与首件检查、BT1 加 +/−、删重复钻带、补可重跑脚本
    - 文档：U7 不是「左上→右上→左下→右下」，是左列 1/2、右列 3/4；首件检查里
    「电池座两孔应当响」写反了（+ 是 VBAT、− 是 GND，必须不响），改成 + ↔ VBAT、− ↔ GND 导通
    - 文档：SW2 是 6×6 轻触键（脚距 7.62×5.08），不能用 2.54 排母；U7 输入/输出各一对排母
    - 丝印：BT1 把「1」换成 +/−；所有方向标记字号 40→50 mil、笔画 8 mil（0.20mm）；U7 的「1」避开 BT1 名字
    - 交付包删掉重复的 Drill_PTH_Through_Via.DRL（11 个文件），避免板厂把排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
2026-11-10 外部审查第二轮整改：丝印全改英文、U7 改按焊点接线、补板框/安装孔脚本与冻结布线数据
2026-11-10 加丝印自检脚本：标记指向与压字检查
2026-11-10 装配说明补实物比对：TB6612 的 VM 必须在左、测距模块看 VIN
2026-11-10 交付说明补阻焊桥宽度实测（0.10mm，等于板厂下限）
2026-11-10 加 release.py：一条命令出交付包并跑四道验证
2026-11-10 审查第三轮整改：丝印字号 70mil 过 JLC 下限、名字避让、脚本护栏
    - 丝印全部 70 mil（实测墨迹 1.03–1.10mm，嘉立创下限 1.0mm），线宽 7/8 mil
    - BT1/U4/U5/U6 名称写在位号正上方，J1/J2 抬高 12mil，避开 1 脚标记
    - 传感器丝印改 TOF L/F/R（原名太长会串到隔壁位号）
    - mask_open 只给 1.0mm 排针孔开窗；silk_pcb 缺位号直接报错；audit_gerber 失败返回非零
    - verify_silk 断言 40 条文字；route_via 检查 pcb clear 是否成功
    - 文档：所有模块都可能 180° 插反的对照表、U7 飞线接法、电池检测缺分压的说明
    - 交付包 11 文件 37028B sha256 12a7d959…
2026-11-10 位号字号也提到 70mil：全板丝印统一过 JLC 1.0mm 字高下限
    - 12 个位号用 eda.pcb_PrimitiveString.modify 改 fontSize/lineWidth 到 70/7
    - 名称按新 bbox 重排；BT1/U4/U5/U6 仍在位号正上方，J1/J2 抬高 12mil
    - 交付包 11 文件 36884B sha256 a20e2d55…；四道验证全 PASS
2026-11-10 审查第四轮：改对插反后果表、位号字号进脚本、文档纠正
    - 文档插反表按实际孔位重算（U1 3V3/GND 短路、U2 VBAT 倒灌、J1/J2 电源短路…），补 BT1 反接
    - silk_pcb.py 自己把位号字号改成 70/7（不再依赖手工），verify_silk 查字号与压框线
    - 电池检测补救写准（33k 只是关掉检查，要真测需 100k+33k）
    - 补：测距模块用排针+杜邦线、先量电池极性、README 四道验证与 sha 更新
    - 交付包 11 文件 36891B sha256 6efaaadd…
2026-11-10 审查第五轮：文档收尾（U4-U6 用排针、电池极性步骤前移、U3/BT1 反插后果写准）
    - §四 焊接清单：U4/U5/U6 改焊 1×6 排针（公针），用杜邦线引到车头
    - 电池极性检查从 §六 挪到 §四 第 3 步（焊完 BT1、接 U7 之前），避免烧 U7
    - 插反表：U3 写清 SDA/SCL→XCL/XDA、INT→3V3、AD0→GND；BT1 补 TB6612 会先烧
    - 墨迹高度数字改为含笔画的 1.1–1.3mm
2026-11-10 审查第六轮：U7 留到上电前焊、插电池前先量短路、墨迹高度数字统一
    - 第四节 U7 改成"这一步先别焊，留到第六节第 1 步"，电池极性检查才保护得到它
    - 第四节第 3 步插电池之前加蜂鸣档确认正负极不响（XH 两脚只隔 2.54mm）
    - 墨迹高度统一成"约 1.2mm / 1.09-1.23mm"，四个文件四种写法收掉
2026-11-10 README 记一笔：外部审查 6 轮、Codex 配额受限改用 Claude
2026-11-11 固件加 BAT_CHECK_ENABLED：本板没接分压，默认关掉电池电压检查
2026-11-12 四轮 + 18650 电池盒改型；洞洞板改 55×37 实板并加自动布线
    CAD：
    - 万向轮改为车头/车尾各一只（x=±58），两驱动轮同轴不动，四轮支撑
    - 电池从 55×32×18 LiPo 换成 2×18650 电池盒 77×40×20，骑在两电机顶上（z26–46），
    主板 45→48，铜柱 M3×30→×32；整备 409 g，重心 x=+4.0，check.py 17 项全过
    - cad_export 的 assembly STL 漏面（报 6186 实写 4162），改为逐体导出再合并；
    重出 maze-car.step/.stl、out/parts、四视图渲染、A3 总装图
    - 文档同步：ASSEMBLY/CHECKLIST/MEASURE/PROGRESS/ASSETS、硬件笔记、赛情与决策
    布线：
    - layout.py 改用 55×37 孔实板（约 140×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
    [b1-底板.stl, b129-ESP32-USB.stl, b130-左电机-安装法兰.stl, b131-右电机-安装法兰.stl, b132-左电机-输出座.stl, b135-右电机-输出座.stl, b136-测距-左6P座.stl, b137-测距-右6P座.stl]
2026-11-13 布线图加测量模式：点两点报万用表理想读数（同网 0Ω / 电源对地容性 / 经稳压器无意义 / 开路），并带常用检查快捷对
